FrameworkComputer/ExpansionBay/Dual SSD Reference Design/README.md

# Dual SSD Reference Design
This is a reference design of a Dual M.2 SSD Module that goes in the Expansion Bay Shell.  Note that other M.2 PCIe devices can also be used.

This design has been prototyped and put through limited testing, but additional validation is needed for a production version.

## License
Expansion Bay © 2023 by Framework Computer Inc is licensed under CC BY 4.0. To view a copy of this license, visit http://creativecommons.org/licenses/by/4.0/
