FrameworkComputer/ExpansionBay/PCB Reference Design/README.md

# PCB Reference Design
This is a reference drawing for a blank PCB that goes in the Expansion Bay Shell.  You can use it as a starting point for new PCBs.

## License
Expansion Bay © 2023 by Framework Computer Inc is licensed under CC BY 4.0. To view a copy of this license, visit http://creativecommons.org/licenses/by/4.0/
