FrameworkComputer/ExpansionBay/Mechanical/ExpansionBayShell/README.md

# Expansion Bay Shell
In order to place the PCBs at the right Z-height, you'll need to use standoffs.
A 3D-printable version is in this folder.  You can also request SMT versions through
the form here: https://forms.gle/iLWjxfMheLws1QaY7
