FrameworkComputer/ExpansionBay/Mechanical/ExpansionBayShell/fw_expansion_bay_standoff_1_long.stl

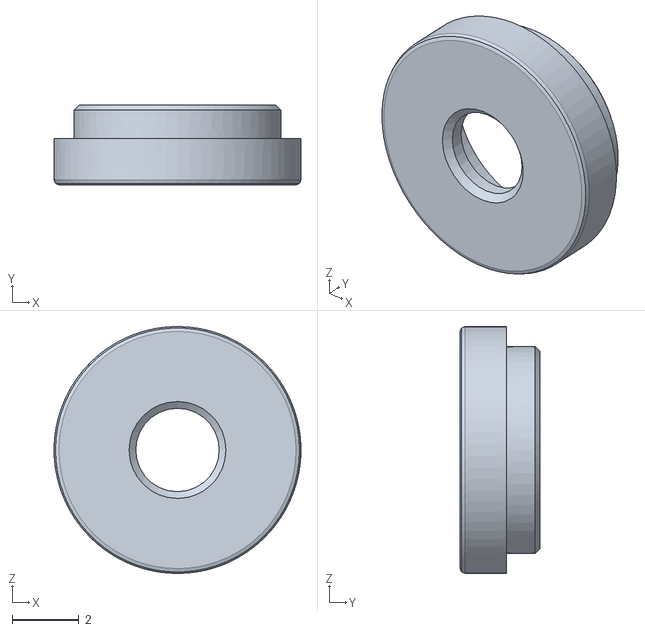
[picture p1: CAD file, 2025-09-09]
Mechanical/ExpansionBayShell/fw_expansion_bay_standoff_1_long.stl
7.40 x 2.40 x 7.40
