FrameworkComputer/ExpansionBay/PCB Reference Design/fw_expansion_bay_pcb_02_0807.dxf

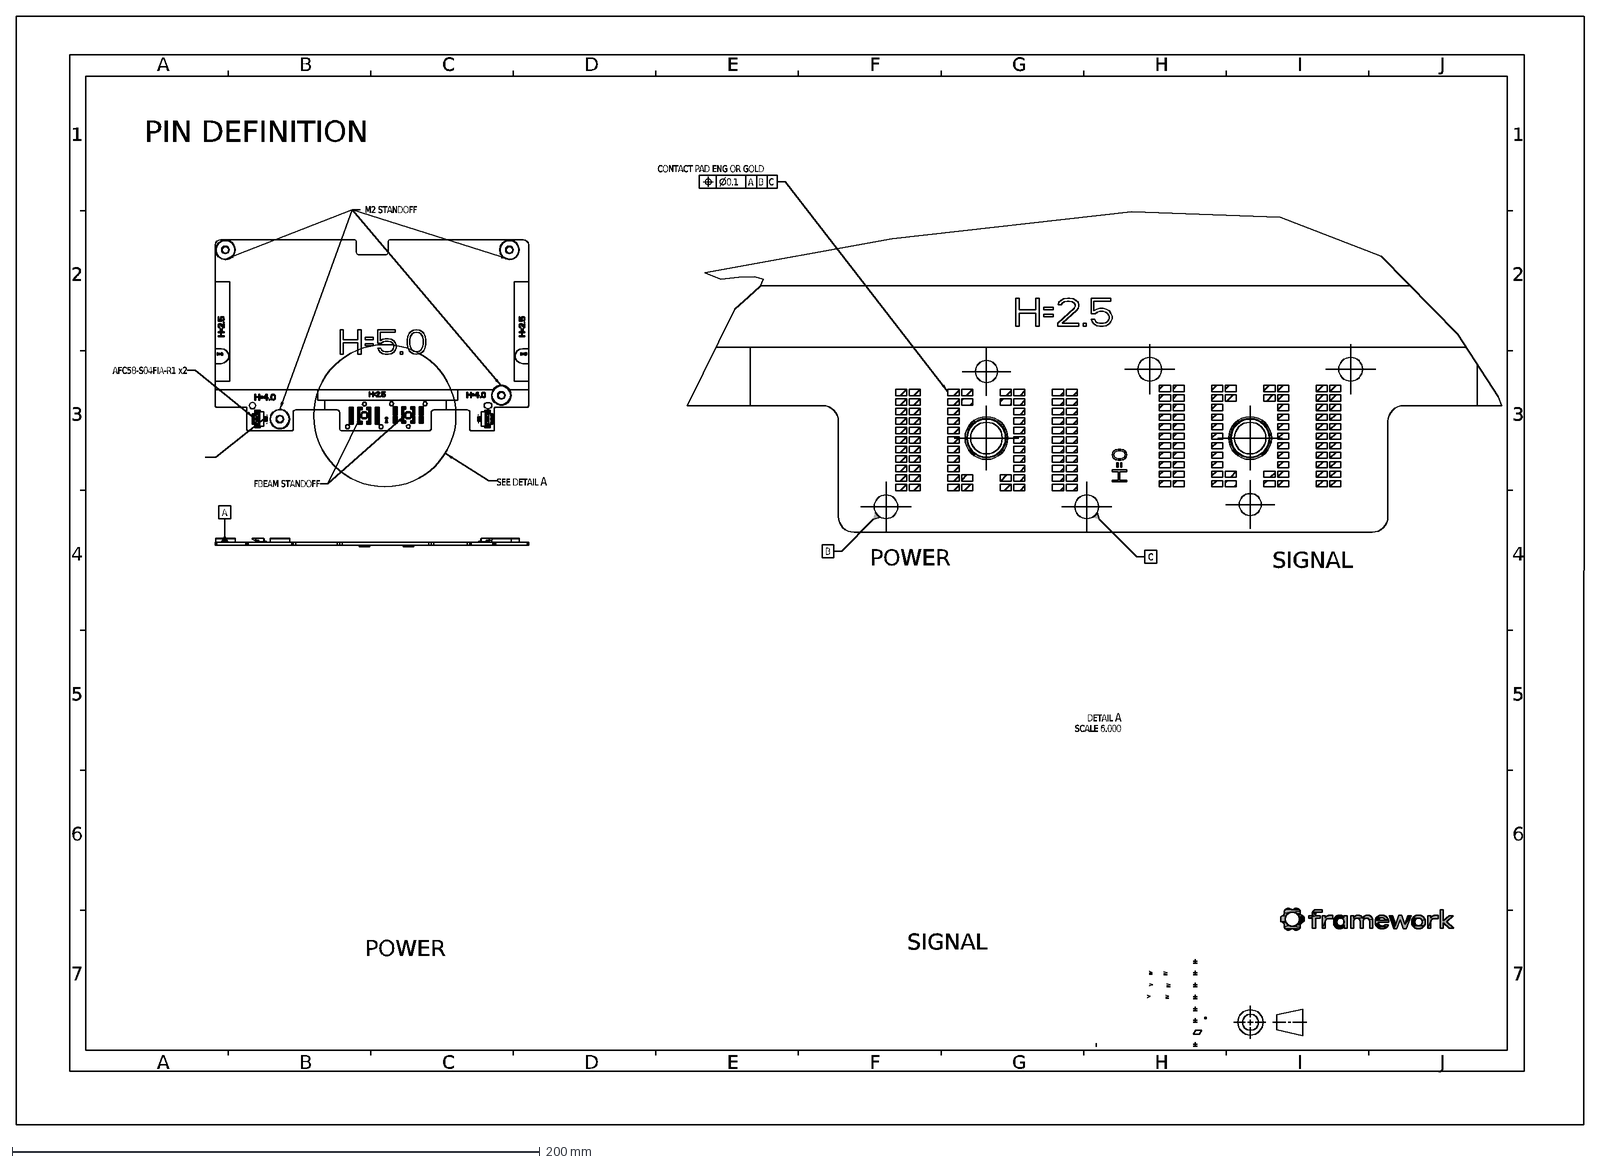
[picture p2: CAD file, 2023-08-07]
PCB Reference Design/fw_expansion_bay_pcb_02_0807.dxf
A
7
6
5
C
B
D
1
4
3
2
E
F
G
H
I
J
PIN DEFINITION
POWER
SIGNAL
SEE DETAIL A
AFC58-S04FIA-R1 x2
M2 STANDOFF
FBEAM STANDOFF
DETAIL A SCALE 6.000
CONTACT PAD ENG OR GOLD
0.1
