FrameworkComputer/ExpansionBay/Dual SSD Reference Design/fw_ssd_pcb_ref_design_0_1.dxf

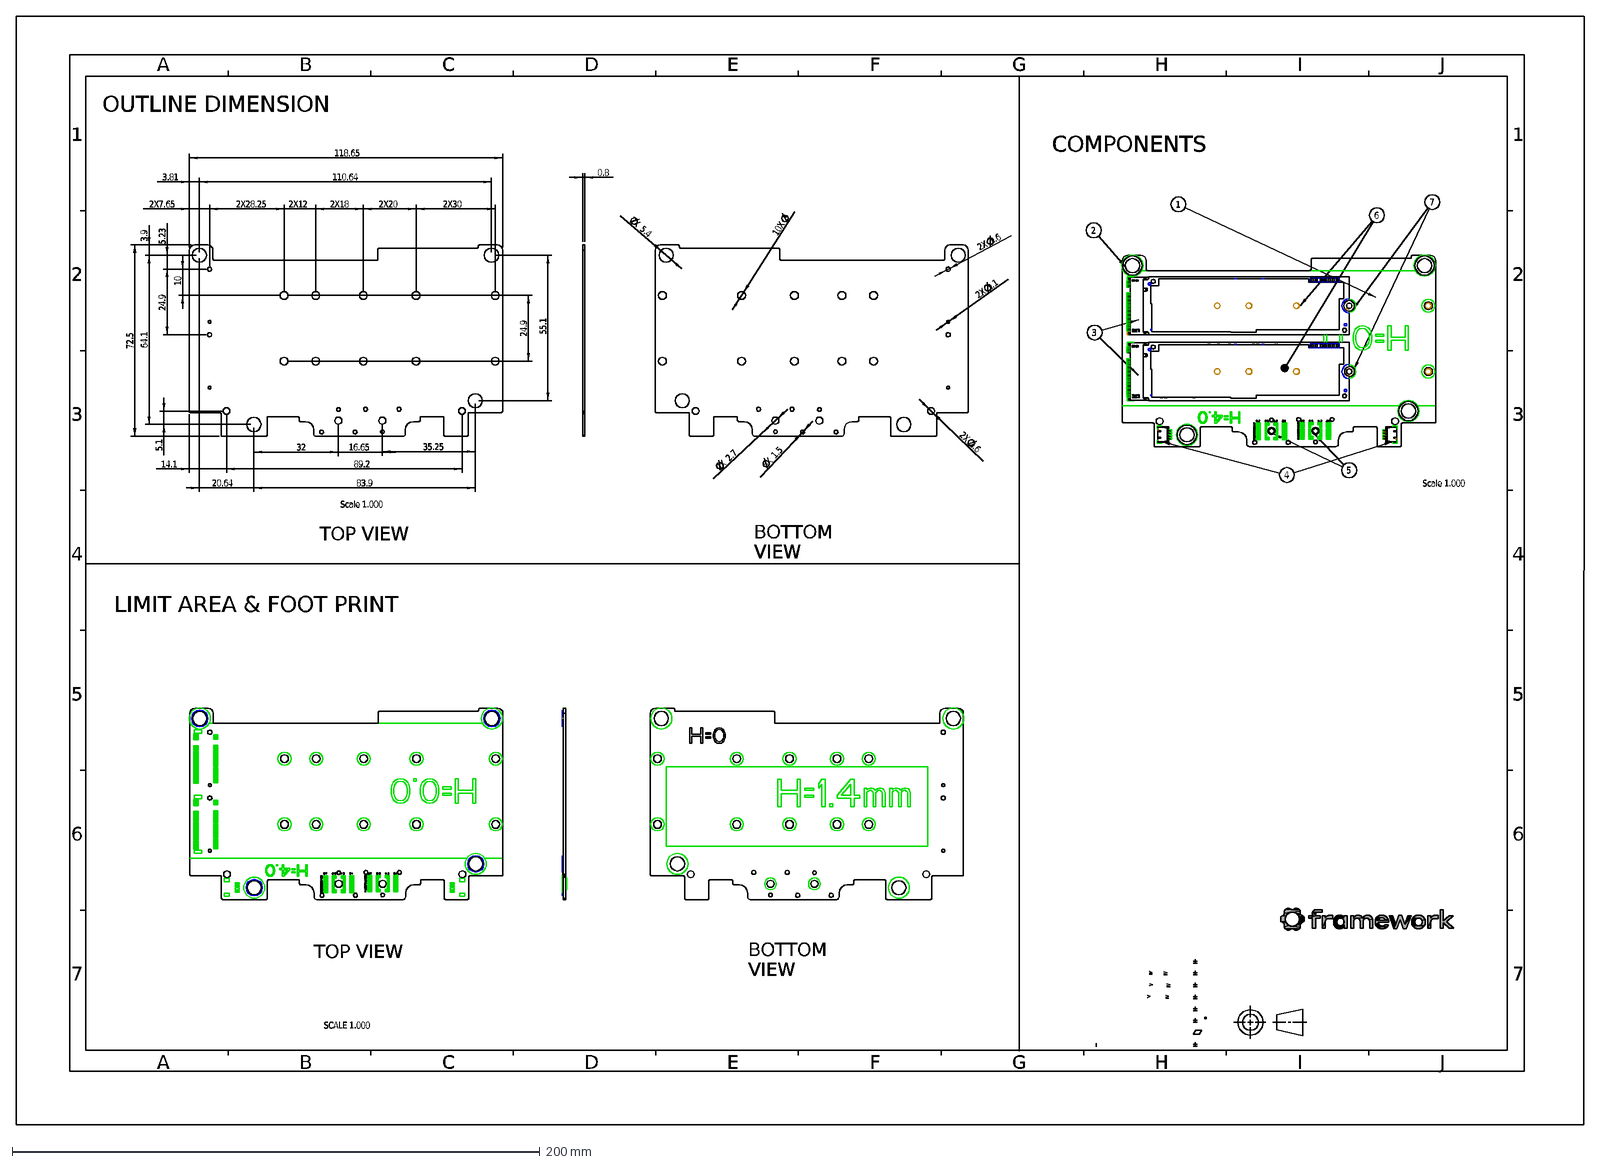
[picture p3: CAD file, 2023-03-20]
Dual SSD Reference Design/fw_ssd_pcb_ref_design_0_1.dxf
A
7
6
5
C
B
D
1
4
3
2
E
F
G
H
I
J
118.65
72.5
0.8
3.81
64.1
2X28.25
2X7.65
2X12
2X18
2X20
2X30
110.64
5.23
24.9
10
89.2
5.1
3.9
20.64
83.9
55.1
14.1
32
16.65
35.25
2X \~5.4
10X \~3
2X \~1.6
2X \~1.1
2X \~2.6
2X \~2.7
6X \~1.5
OUTLINE DIMENSION
TOP VIEW
BOTTOM VIEW
LIMIT AREA & FOOT PRINT
COMPONENTS
Scale 1.000
SCALE 1.000
