FrameworkComputer/ExpansionBay/PCB Reference Design/fw_expansion_bay_pcb_01_0807.dxf

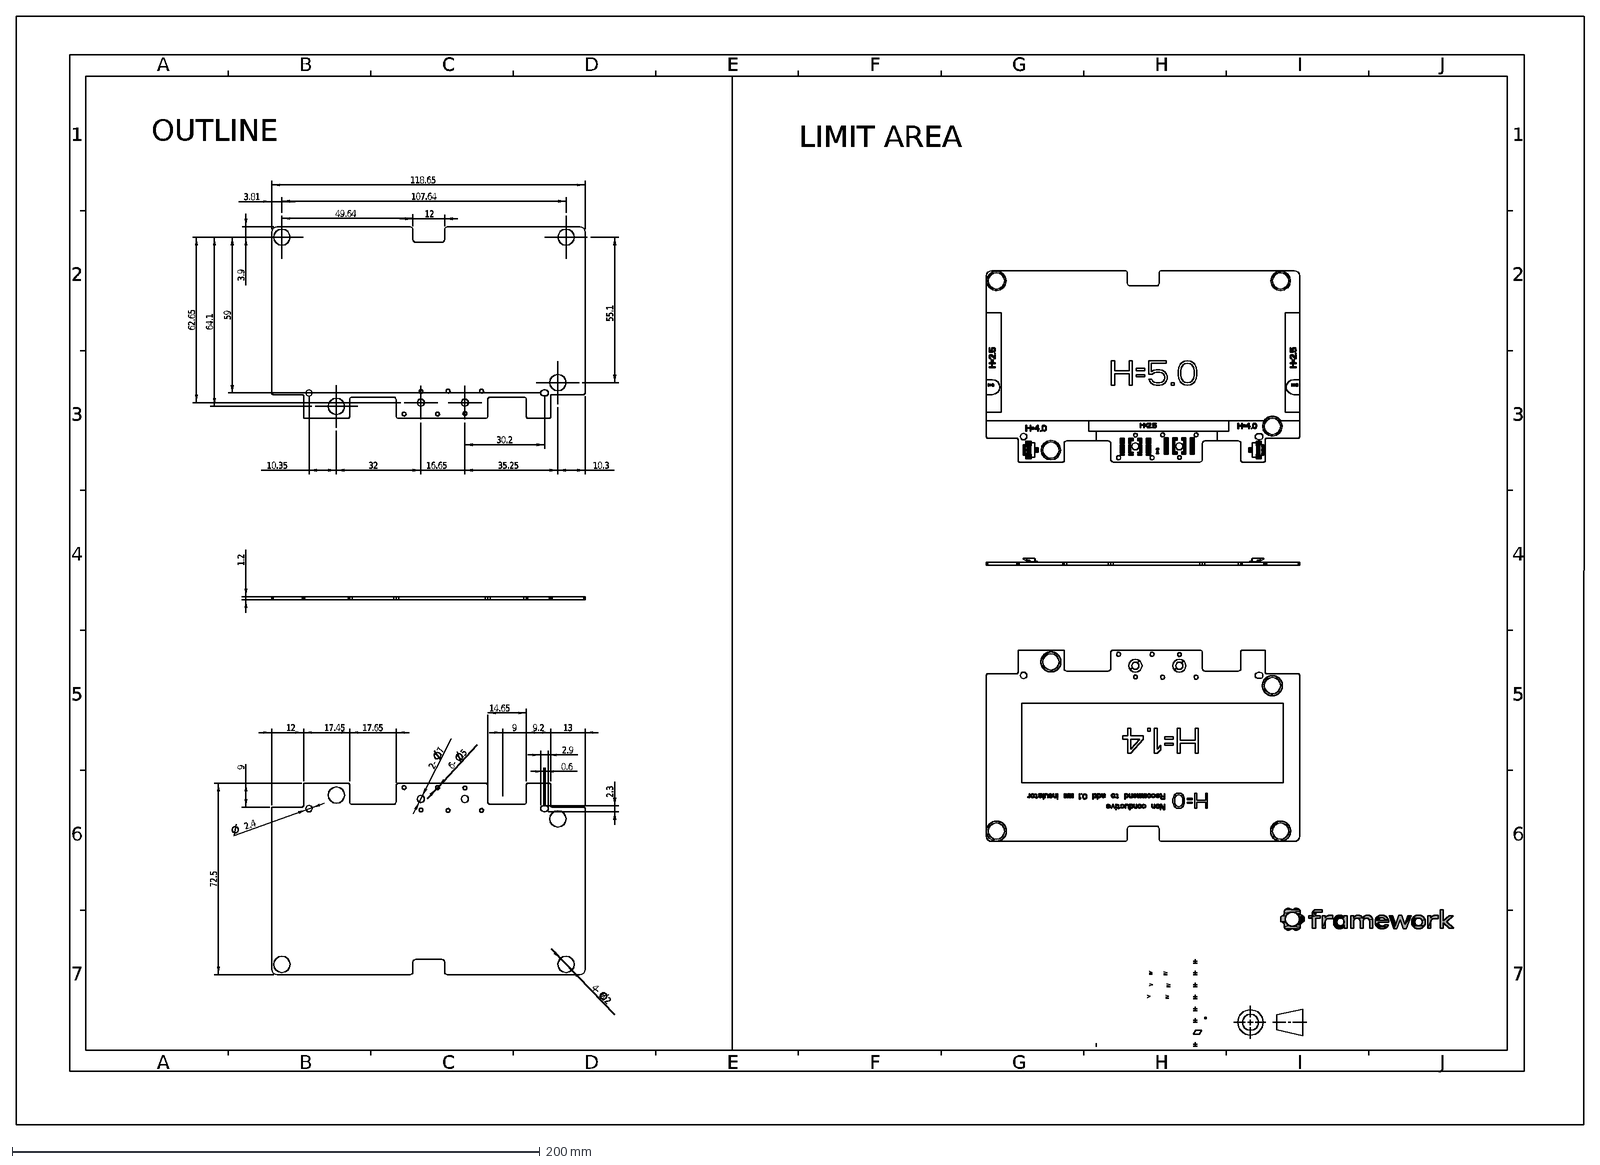
[picture p4: CAD file, 2023-08-07]
PCB Reference Design/fw_expansion_bay_pcb_01_0807.dxf
A
7
6
5
C
B
D
1
4
3
2
E
F
G
H
I
J
1.2
107.64
118.65
3.9
3.81
64.1
32
16.65
35.25
10.3
10.35
30.2
59
62.65
9
72.5
12
17.65
14.65
9.2
13
17.45
49.64
55.1
4- \~6.2
2- \~2.7
6- \~1.5
2.4
0.6
2.9
2.3
LIMIT AREA
OUTLINE
