FrameworkComputer/ExpansionBay/(list of files, cad)

Other CAD files:
Dual SSD Reference Design/fw_ssd_pcb_ref_design_0_2.dxf
