FrameworkComputer/ExpansionBay/(threads)

Thread 1 (2023-04-02):

How do I open the files in kicad 7.0?

Redstone626, 2023-04-02:
this is my first time using Kicad and I would like to try and make something for the 16in framework but don't know how to open these files in Kicad

eclecticc, 2023-04-15:
These are mechanical drawings.  I recommend waiting until we or a community member create a KiCAD template using them.

Closed 2023-04-15.

Thread 2 (2023-04-02):

Estimated thickness, External ports?

maxtim10, 2023-04-02:
Need the dimensions and details of not just PCBA but the housing.  Planning to start development work on an industry-specific expansion module, but I need to at least know the rough dimensions to determine feasibility.

In the Framework announcement, it was stated thickness can be whatever, but I'm sure the PCBA will need a connection port to "slot in" the mainboard.

Another point that I need clarification on is will the housing be all the way at the back of the laptop for potentially additional port additional ports, etc.

NickelLiang, 2023-04-03:
Also want to have more details about the dimensions of the housing, also planning on an industry-specific expansion module.

We already know that our expansion module definitely will not fit in the standard Expansion Bay Shell, so a reference design for Graphics Module / no Z-height limitation module will be of great help for us to evaluate the feasibility of implementing our solution as a module for Framework 16.

Thanks!

Cutieguwu, 2024-01-23:
Going to quickly bump this.

Details regarding the housing design and base construction are very important for custom module design. Expanding the housing from a base model is easy if you don't have to reconstruct all of the housing in contact with the laptop beforehand (Connectors, rails, etc). Also helpful if you plan to produce a module for a shell before you have the laptop on hand. Then you can at least begin the initial design and build stage before proper testing.

Thread 4 (2023-05-19):

Where does the DisplayPort connector lead?

Dakkaron, 2023-05-19:
Does it go to the internal display (thus bypassing the need to route the video signal over PCIE), to the IO (to attach external displays) or somehow to the CPU/integrated GPU?

Or is it the output coming from the iGPU?

What can it be used for?

Dakkaron, 2023-06-14:
That's really cool, thanks!

jyancat, 2023-06-21:
I'd suggest you mark this as closed.

Closed 2023-06-21.

Thread 7 (2023-08-03):

Exact PCB dimensions & Case Interface port

Seneral, 2023-08-03:
I'd like to verify the dimensions and shape of the PCB.

First, the given PCB has cutouts when it is not obvious why they are there - e.g. the large retreating edge where the interface slot in the shell casing should be, as well as the cutouts next to the bottom edge hole cutouts (where the GPU shell does allow for PCB according to earlier videos and photos).
Can you confirm the shell allows for the following additional PCB space to be used?
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

Especially the top edge is important. In addition to what the shell back end will look like in regards to distance to the specified PCB edge. From videos I already inferred the removable backend for ports likely spans the entire 118.65mm - is that also correct?

Thank you for the help

Seneral, 2023-08-03:
I overlayed them in an image editor and there seem to be a few minor changes.
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
As expected, the interface connector changed (the verge mentioned they used a temporary one for the shell), the left fan header moved a bit, and the PCB shape changed a bit.

But the top confuses me. None of the three holes are screwed in, which means they are likely not responsible for the port cover mounting. But the given PCB shape also covers the middle screw, so probably nothing above uses it. Is it solely for the PCB to use, in case it goes beyond the shell bounds?
This would be beneficial since we could then ignore the side screws and use a 100mm wide board, which is a LOT cheaper at e.g. jlcpcb.

Additionally, it seems there is still quite a bit of space between the PCB edge and the port cover, so we'd definitely need details or we'd have completely recessed ports

Again thanks for any additional information

Closed 2024-04-28.

Thread 8 (2023-08-05):

Purpose of PCIe Clock Buffer in Dual SSD Reference Design

Seneral, 2023-08-05:
Hello,
Looking at the SSD Reference Design, you employ the PI6CB33202 PCIe Clock Buffer.
By default it is in PLL Bypass mode (so both outputs are always on, with the input clock being passed through), however it could in theory be used to disable or re-drive the clock signal for each port using the SMBus/I2C interface.
Is this actively used in modern OSs by default? I have not found any information on default I2C drivers for adress 0x6C, which indicates the clock buffer is by default only a vehicle for the clock termination resistors.

Additionally, the pinout specifies that if the board uses two ports, it should use two separate CLKREQ and REFCLK for them (sacrificing DP AUX lanes), which the reference design does not. This should in theory eliminate the need for the clock buffer entirely, correct?

Can I assume the clock buffer is a remnant from a time when the Expansion Bay Interface did not yet include the alternate pinouts for two separate PCIe ports?
And/or do future Frameworks contain firmware that expect to be able to turn disable each individual port using the PI6CB33202 PCIe Clock Buffer with I2C adress 0x6C?

Thanks for any information. For now I will assume the alternate pinouts are valid and sufficient

PS: I believe the PEX_REFCLK signal being marked as output is wrong, it should be input (to the expansion board)

PS 2: I noticed both SSDs use the same CLK_REQ signal, indicating that one SSD requesting a low-power state would disable both SSDs REF_CLK. This makes me assume the alternate pin assignment was introduced later and is the only solution to use, meaning the current Dual SSD reference design is out of date. Correct?

Seneral, 2023-08-05:
On that note, the SSD reference design doesn't even use EXT_SSD2_CLK_REQ and the other SSD-specific pins. So I assume it is truly outdated.

Another question that is wide open is how is the second PCIe port activated then, so that DP AUX is disabled?
Is it controlled over the yet undocumented DDS I2C (Expansion Bay Module control)?

Side note, this is not relevant to me specifically anymore, since it sacrifices the DP AUX pair which seems to be required for DP to work, I opted to use the original REFCLK (and pull CLKREQ down)

Closed 2023-10-19.

Thread 9 (2023-08-06):

AC Coupling Capacitor on Differential Pairs

Seneral, 2023-08-06:
Can we assume both DisplayPort and PCIe TX lanes have AC coupling capacitors on the motherboard, or does the design assume we use the 3V/5V given as a power supply for the receiver?
From [quick research](https://electronics.stackexchange.com/a/364996) they could have been omitted if that assumption was made.
The reason I am asking is because I plan to route the PCIe lanes outside the chassis using OCuLink, so the receiver will obviously use a different power supply. Having to place them myself this far after the transmitter would add a lot of reflections to my knowledge.

Closed 2023-10-19.
