FrameworkComputer/ExpansionBay/Dual SSD Reference Design/ssd holder_r00_20230105pm.pdf

# MODEL : SSD HOLDER

# Revision : R00

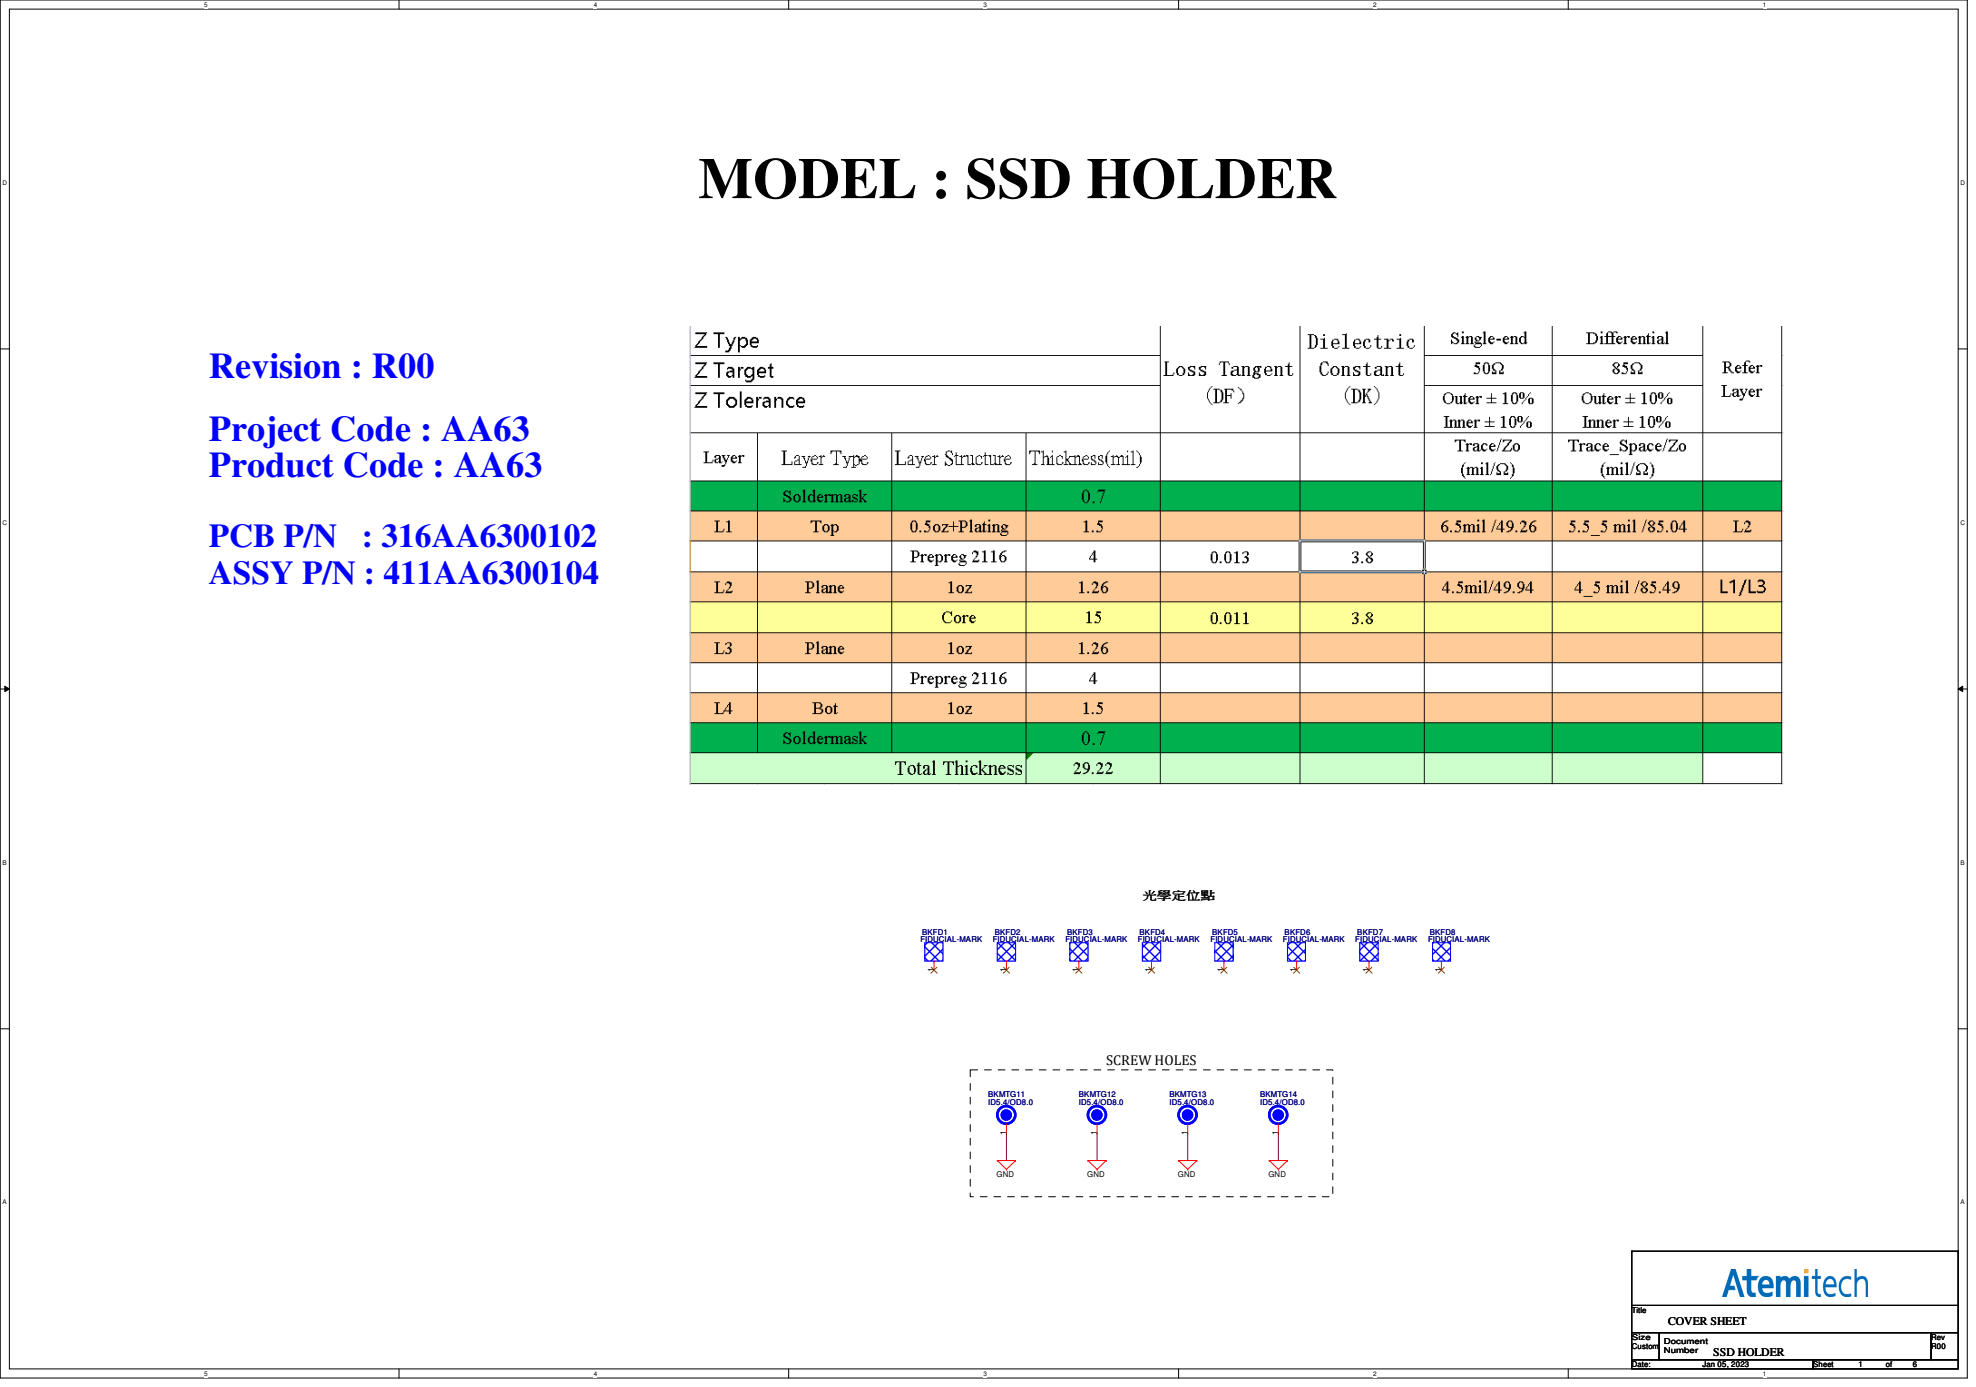
[picture p9: page 1]
GND; Title; Size; Document; Number; Rev; Date:; Sheet; SSD HOLDER; COVER SHEET; Custom; Jan 05, 2023; 光光光光光; SCREW HOLES; ASSY P/N : 411AA6300104; Project Code : AA63; PCB P/N : 316AA6300102; Product Code : AA63; BKMTG13 ID5.4/OD8.0; BKFD7 FIDUCIAL-MARK; BKFD1 FIDUCIAL-MARK; BKMTG12 ID5.4/OD8.0; BKFD6 FIDUCIAL-MARK; BKMTG11 ID5.4/OD8.0; BKFD5 FIDUCIAL-MARK; BKFD4 FIDUCIAL-MARK; BKFD3 FIDUCIAL-MARK; BKFD8 FIDUCIAL-MARK; BKFD2 FIDUCIAL-MARK; BKMTG14 ID5.4/OD8.0

# M.2 SSD (M-KEY)

# 130mil

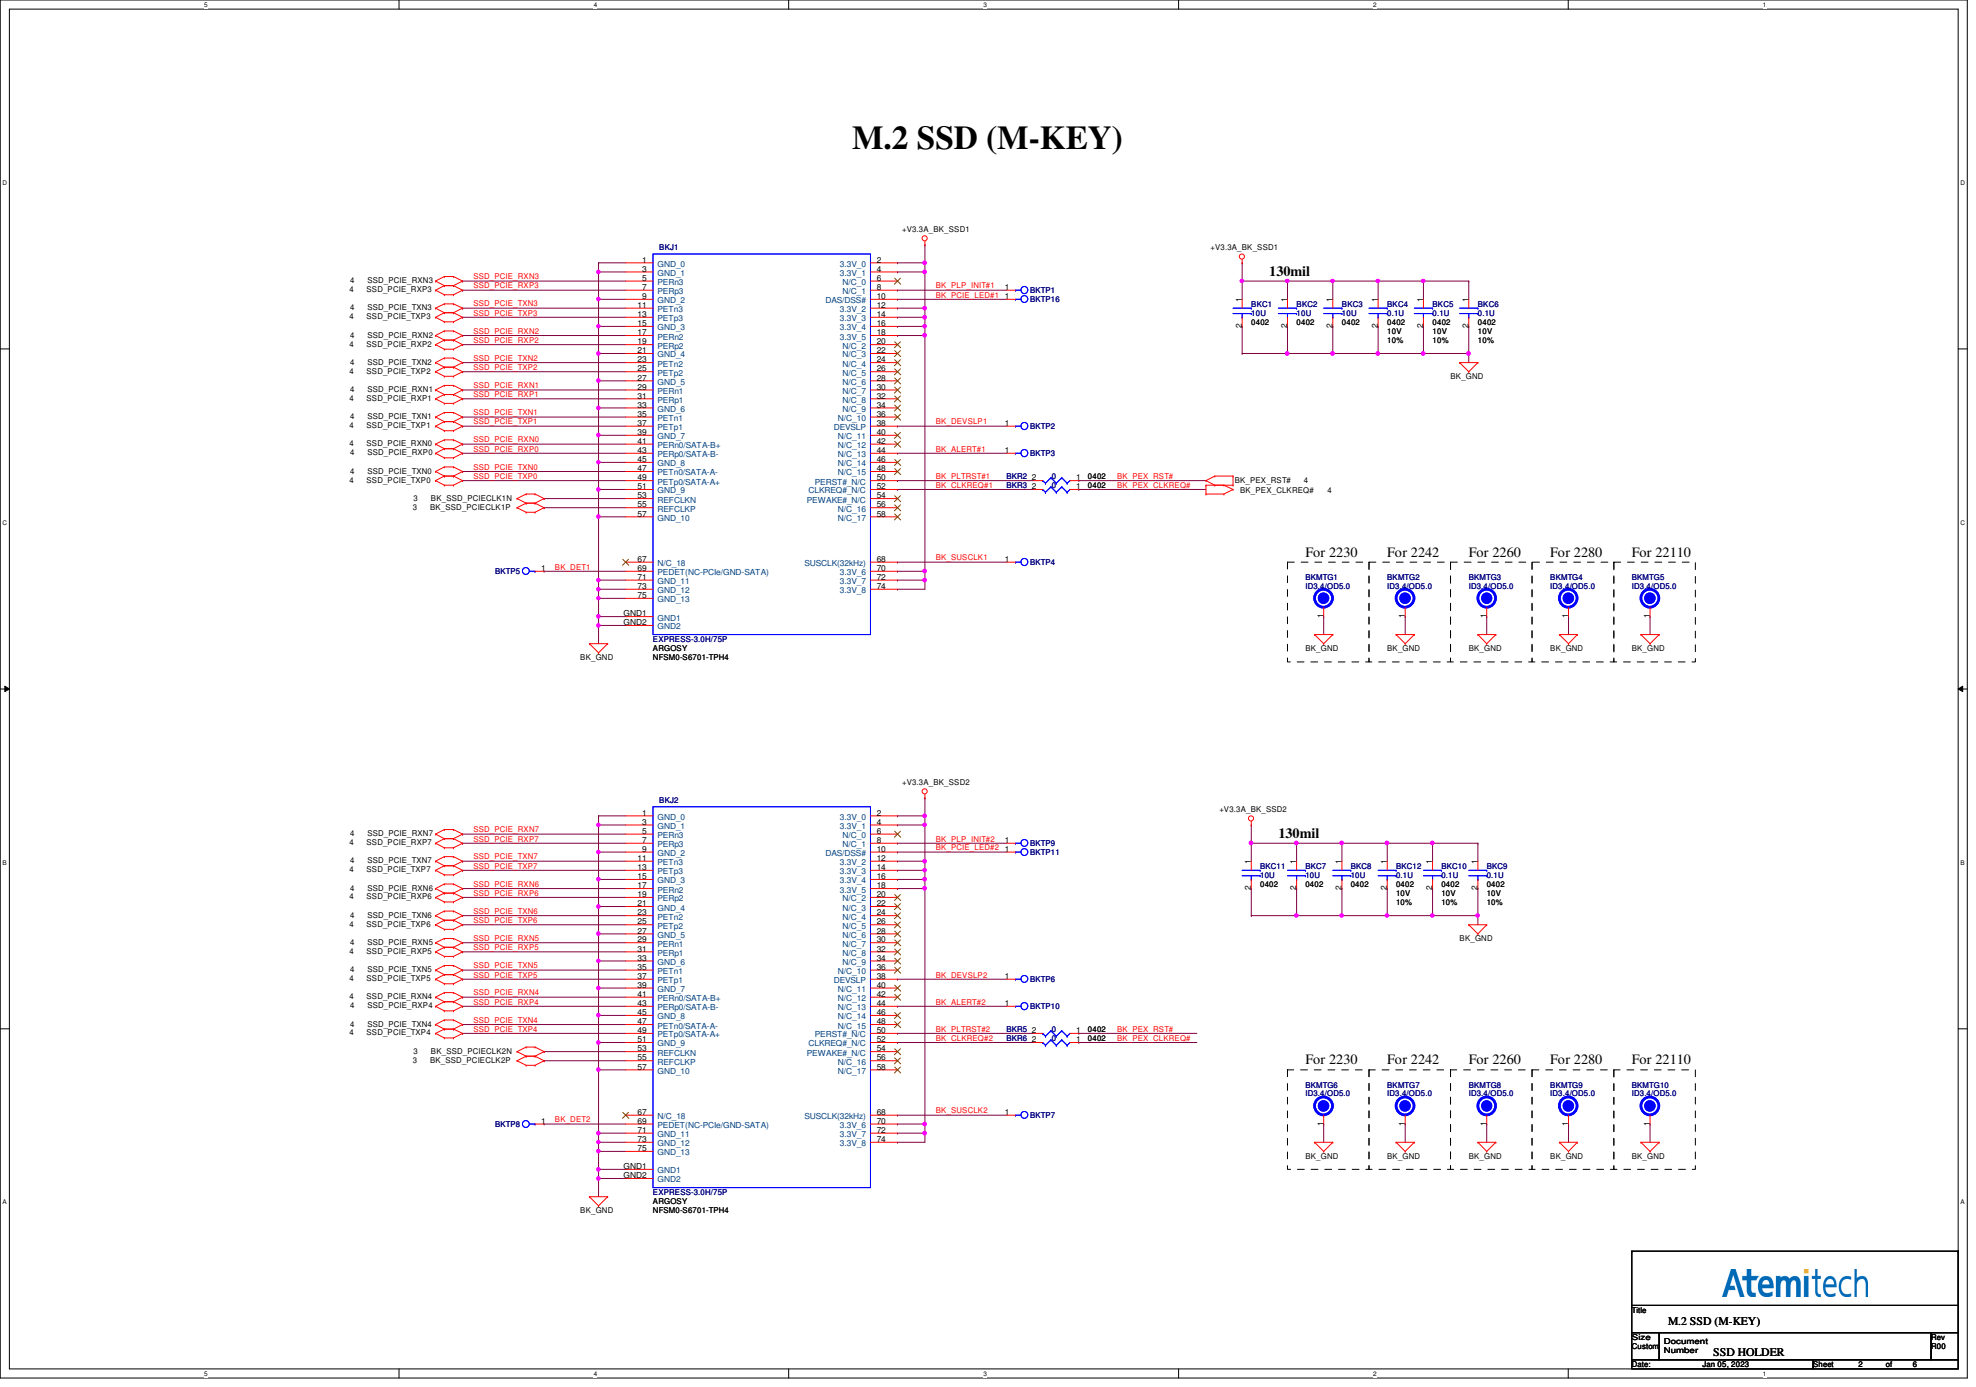
[picture p10: page 2]
BK_PLTRST#1 BK_CLKREQ#1; SSD_PCIE_TXP3; SSD_PCIE_TXN3; SSD_PCIE_RXN3 SSD_PCIE_RXP3; SSD_PCIE_RXP2; SSD_PCIE_RXN2; SSD_PCIE_RXN1 SSD_PCIE_RXP1; SSD_PCIE_TXN1 SSD_PCIE_TXP1; BK_SUSCLK1; BK_DEVSLP1; BK_PCIE_LED#1; BK_DET1; SSD_PCIE_TXN2 SSD_PCIE_TXP2; SSD_PCIE_TXN0 SSD_PCIE_TXP0; SSD_PCIE_RXN0 SSD_PCIE_RXP0; BK_PLP_INIT#1; BK_ALERT#1; BK_PEX_RST# BK_PEX_CLKREQ#; SSD_PCIE_RXN4 SSD_PCIE_RXP4; BK_PLP_INIT#2; BK_ALERT#2; BK_PLTRST#2 BK_CLKREQ#2; SSD_PCIE_TXP7; SSD_PCIE_TXN7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

# PCIE CLOCK BUFFER (PI6CB33202ZDIEX)

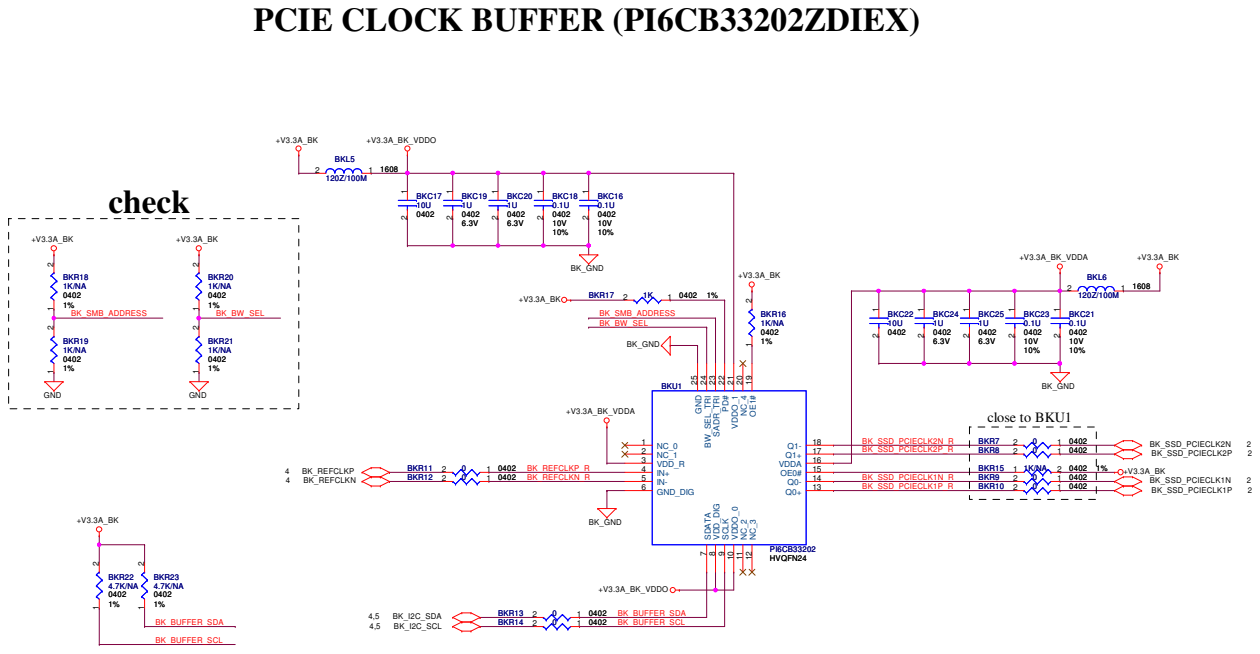
[picture p11: page 3]
BK_SSD_PCIECLK2N_R BK_SSD_PCIECLK2P_R; BK_SSD_PCIECLK1N_R BK_SSD_PCIECLK1P_R; BK_REFCLKP_R BK_REFCLKN_R; BK_BUFFER_SDA BK_BUFFER_SCL; BK_SMB_ADDRESS BK_BW_SEL; BK_SMB_ADDRESS; BK_BW_SEL; BK_BUFFER_SCL; BK_BUFFER_SDA; BK_SSD_PCIECLK2N; BK_SSD_PCIECLK2P; BK_SSD_PCIECLK1N; BK_SSD_PCIECLK1P; 4 BK_REFCLKP 4 BK_REFCLKN; BK_I2C_SDA; BK_I2C_SCL; BK_GND; +V3.3A_BK_VDDO; +V3.3A_BK_VDDA; GND; Jan 05, 2023; close to BKU1; check; BKR11; BKC21 0.1U 0402 10V 10%; BKC25 1U 0402 6.3V; BKR14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

PCIE CLOCK BUFFER (PI6CB33202ZDIEX)

# DUAL CHANNEL 74P PCB

# Signal PIN

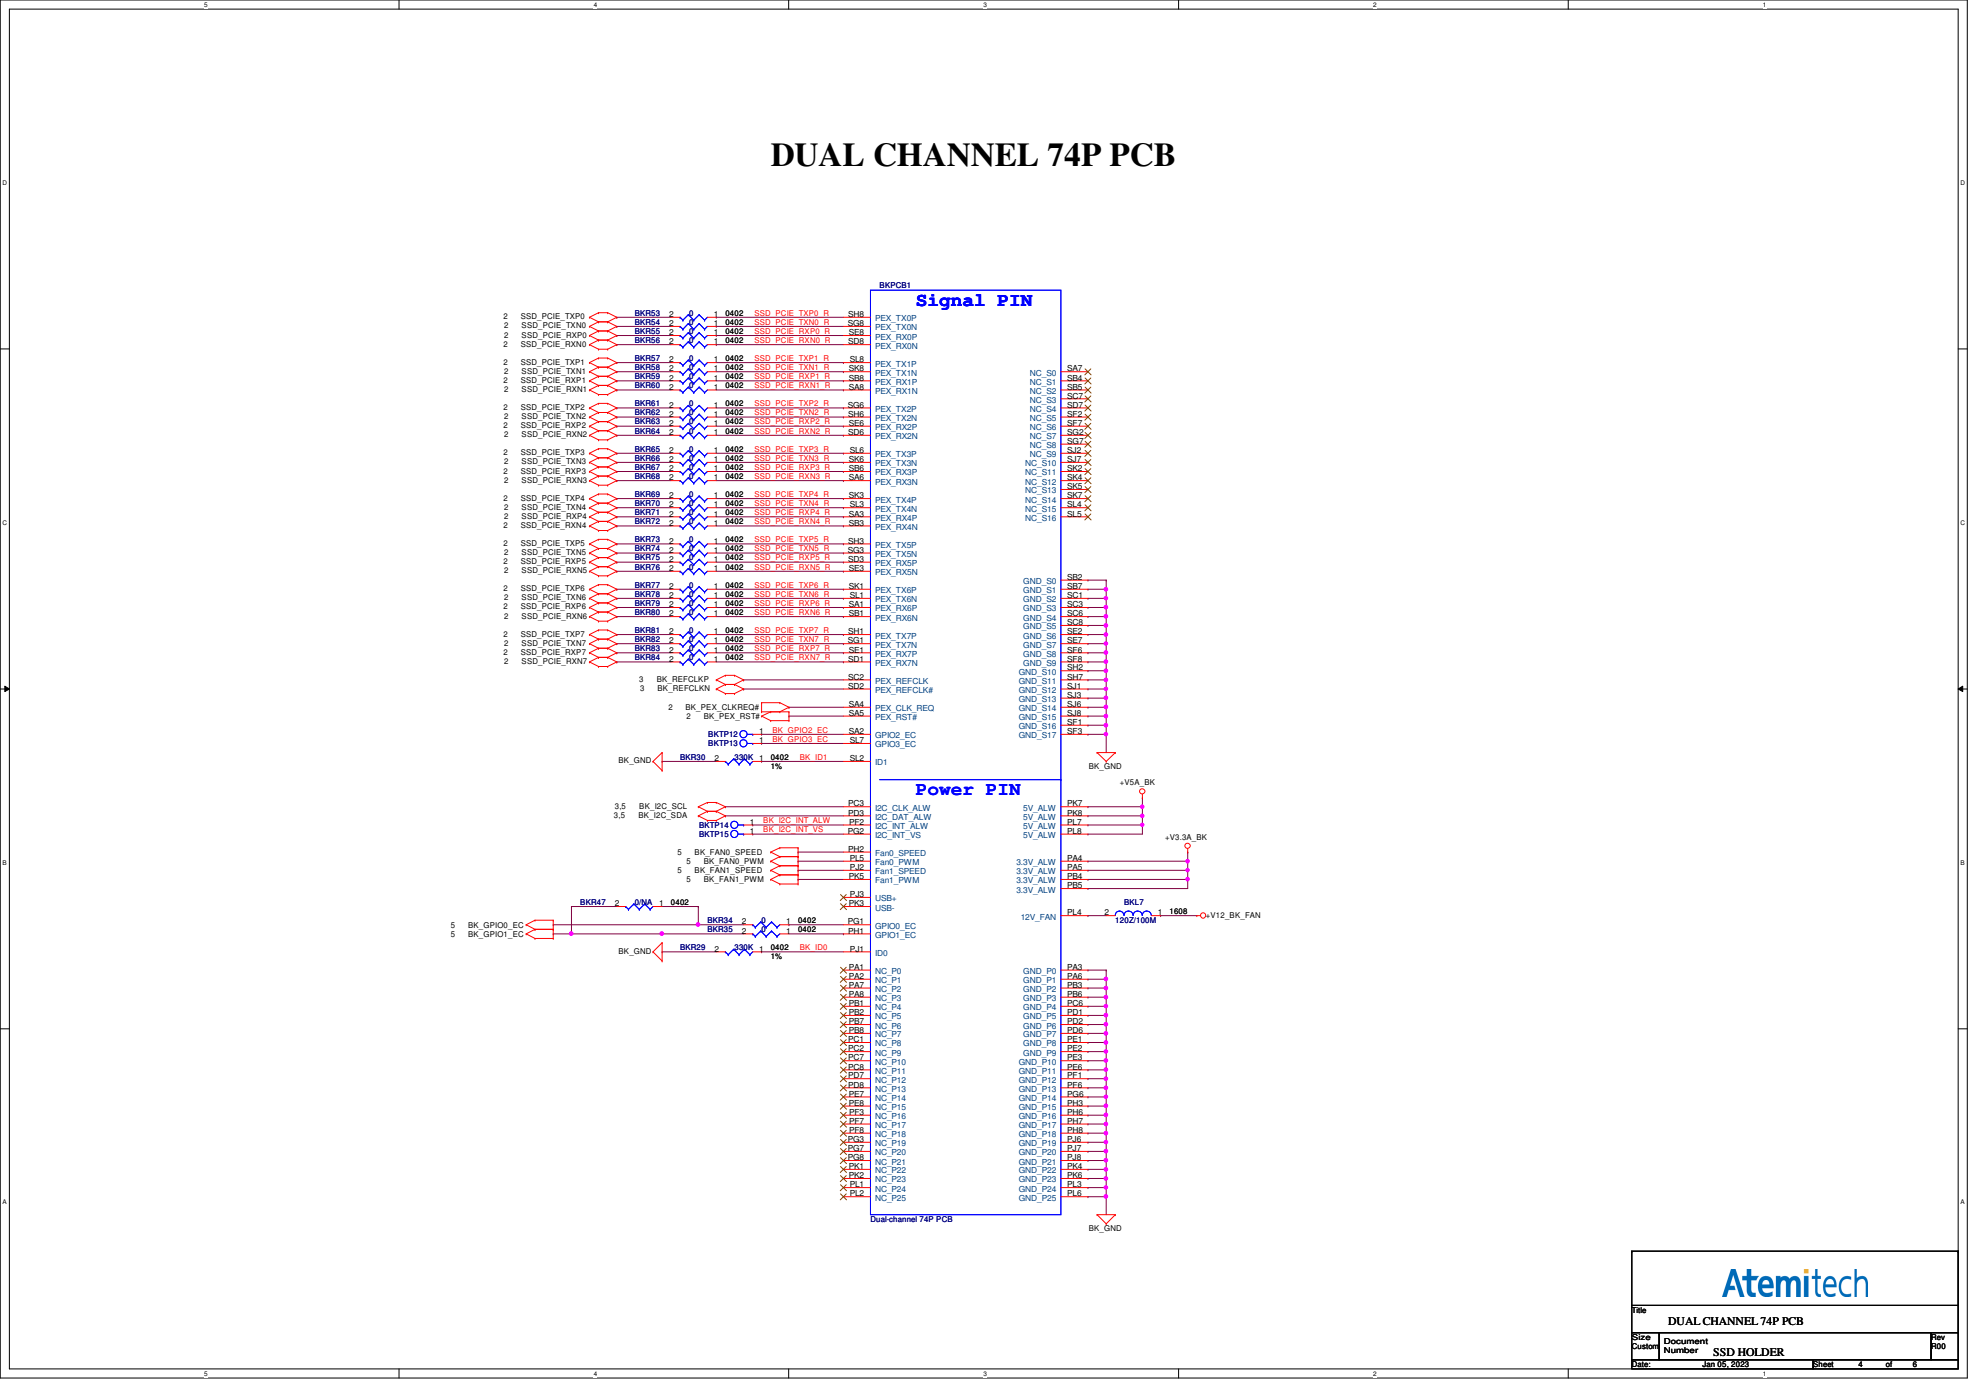
[picture p12: page 4]
BK_GPIO2_EC BK_GPIO3_EC; BK_I2C_INT_ALW BK_I2C_INT_VS; SSD_PCIE_TXP0_R SSD_PCIE_TXN0_R SSD_PCIE_RXP0_R SSD_PCIE_RXN0_R; SSD_PCIE_TXP1_R SSD_PCIE_TXN1_R SSD_PCIE_RXP1_R SSD_PCIE_RXN1_R; SSD_PCIE_TXP2_R SSD_PCIE_TXN2_R SSD_PCIE_RXP2_R SSD_PCIE_RXN2_R; SSD_PCIE_TXP3_R SSD_PCIE_TXN3_R SSD_PCIE_RXP3_R SSD_PCIE_RXN3_R; SSD_PCIE_TXP4_R SSD_PCIE_TXN4_R SSD_PCIE_RXP4_R SSD_PCIE_RXN4_R; SSD_PCIE_TXP5_R SSD_PCIE_TXN5_R SSD_PCIE_RXP5_R SSD_PCIE_RXN5_R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

Dual-channel 74P PCB

DUAL CHANNEL 74P PCB

# EEPROM & FAN & POWER GATE

# FAN CONN

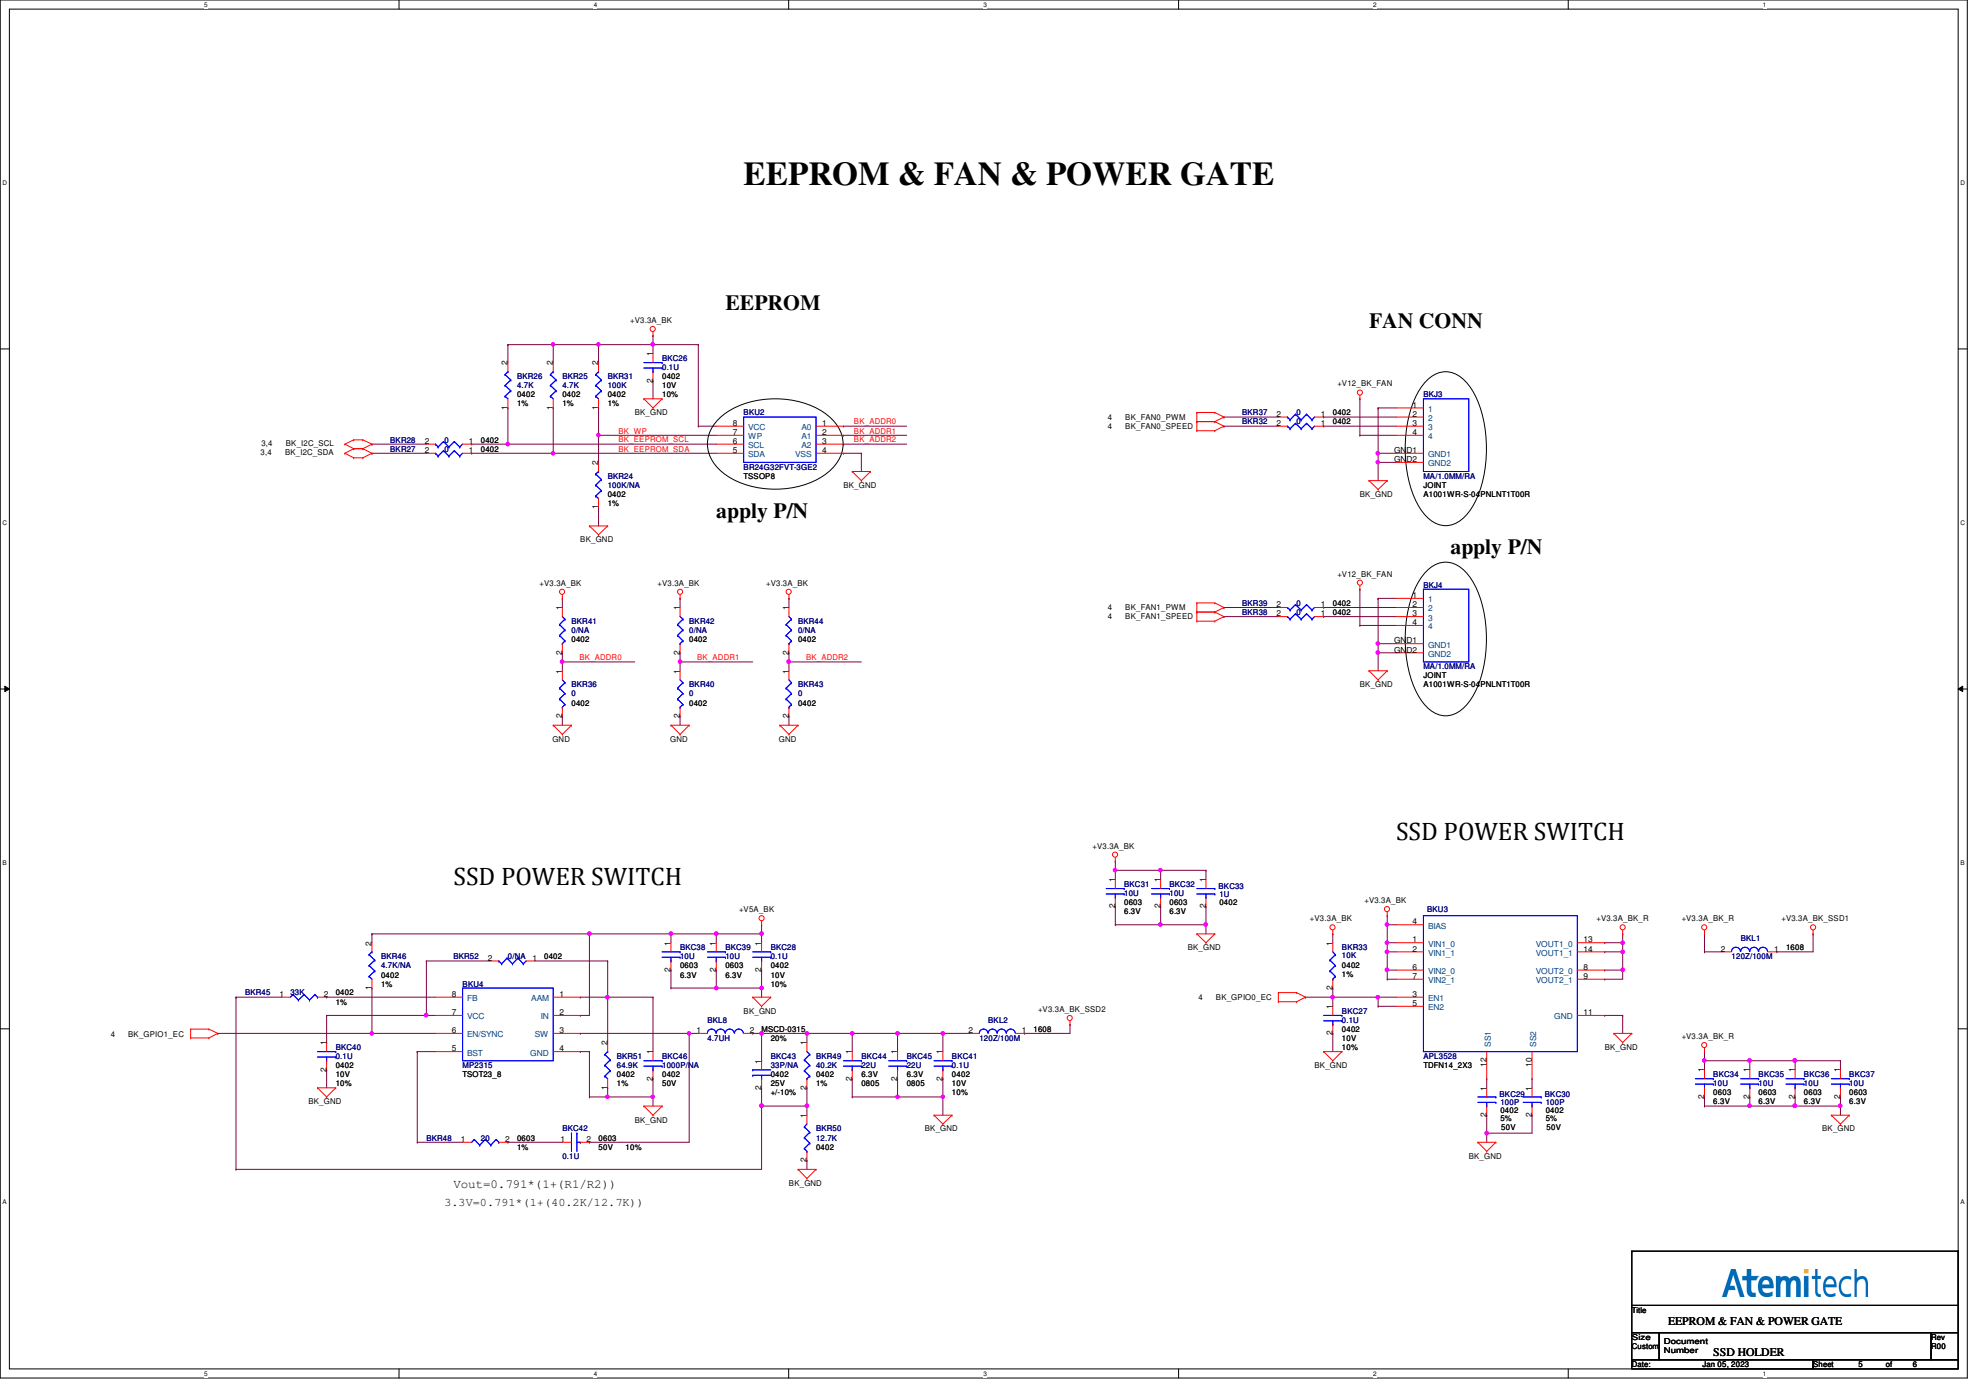
[picture p13: page 5]
BK_ADDR0 BK_ADDR1 BK_ADDR2; BK_EEPROM_SDA; BK_EEPROM_SCL; BK_ADDR0; BK_ADDR1; BK_ADDR2; BK_I2C_SDA; BK_I2C_SCL; 4 BK_GPIO0_EC; 4 BK_FAN0_PWM 4 BK_FAN0_SPEED; 4 BK_FAN1_PWM 4 BK_FAN1_SPEED; 4 BK_GPIO1_EC; +V12_BK_FAN; BK_GND; +V3.3A_BK_SSD1; GND; +V3.3A_BK_SSD2; Jan 05, 2023; apply P/N; EEPROM; Vout=0.791*(1+(R1/R2)); BKR52; BKL1; BKC29 100P 0402; BKC27 0.1U 0402 10V 10%; BKR27; BKL2; BKR50 12.7K 0402; BKC30 100P 0402; BKR32; BKU4; MP2315 TSOT23_8; AAM; VCC 7; BST 5; EN/SYNC 6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

SSD POWER SWITCH

EEPROM & FAN & POWER GATE

Issued Date | Remark

# HISTORY

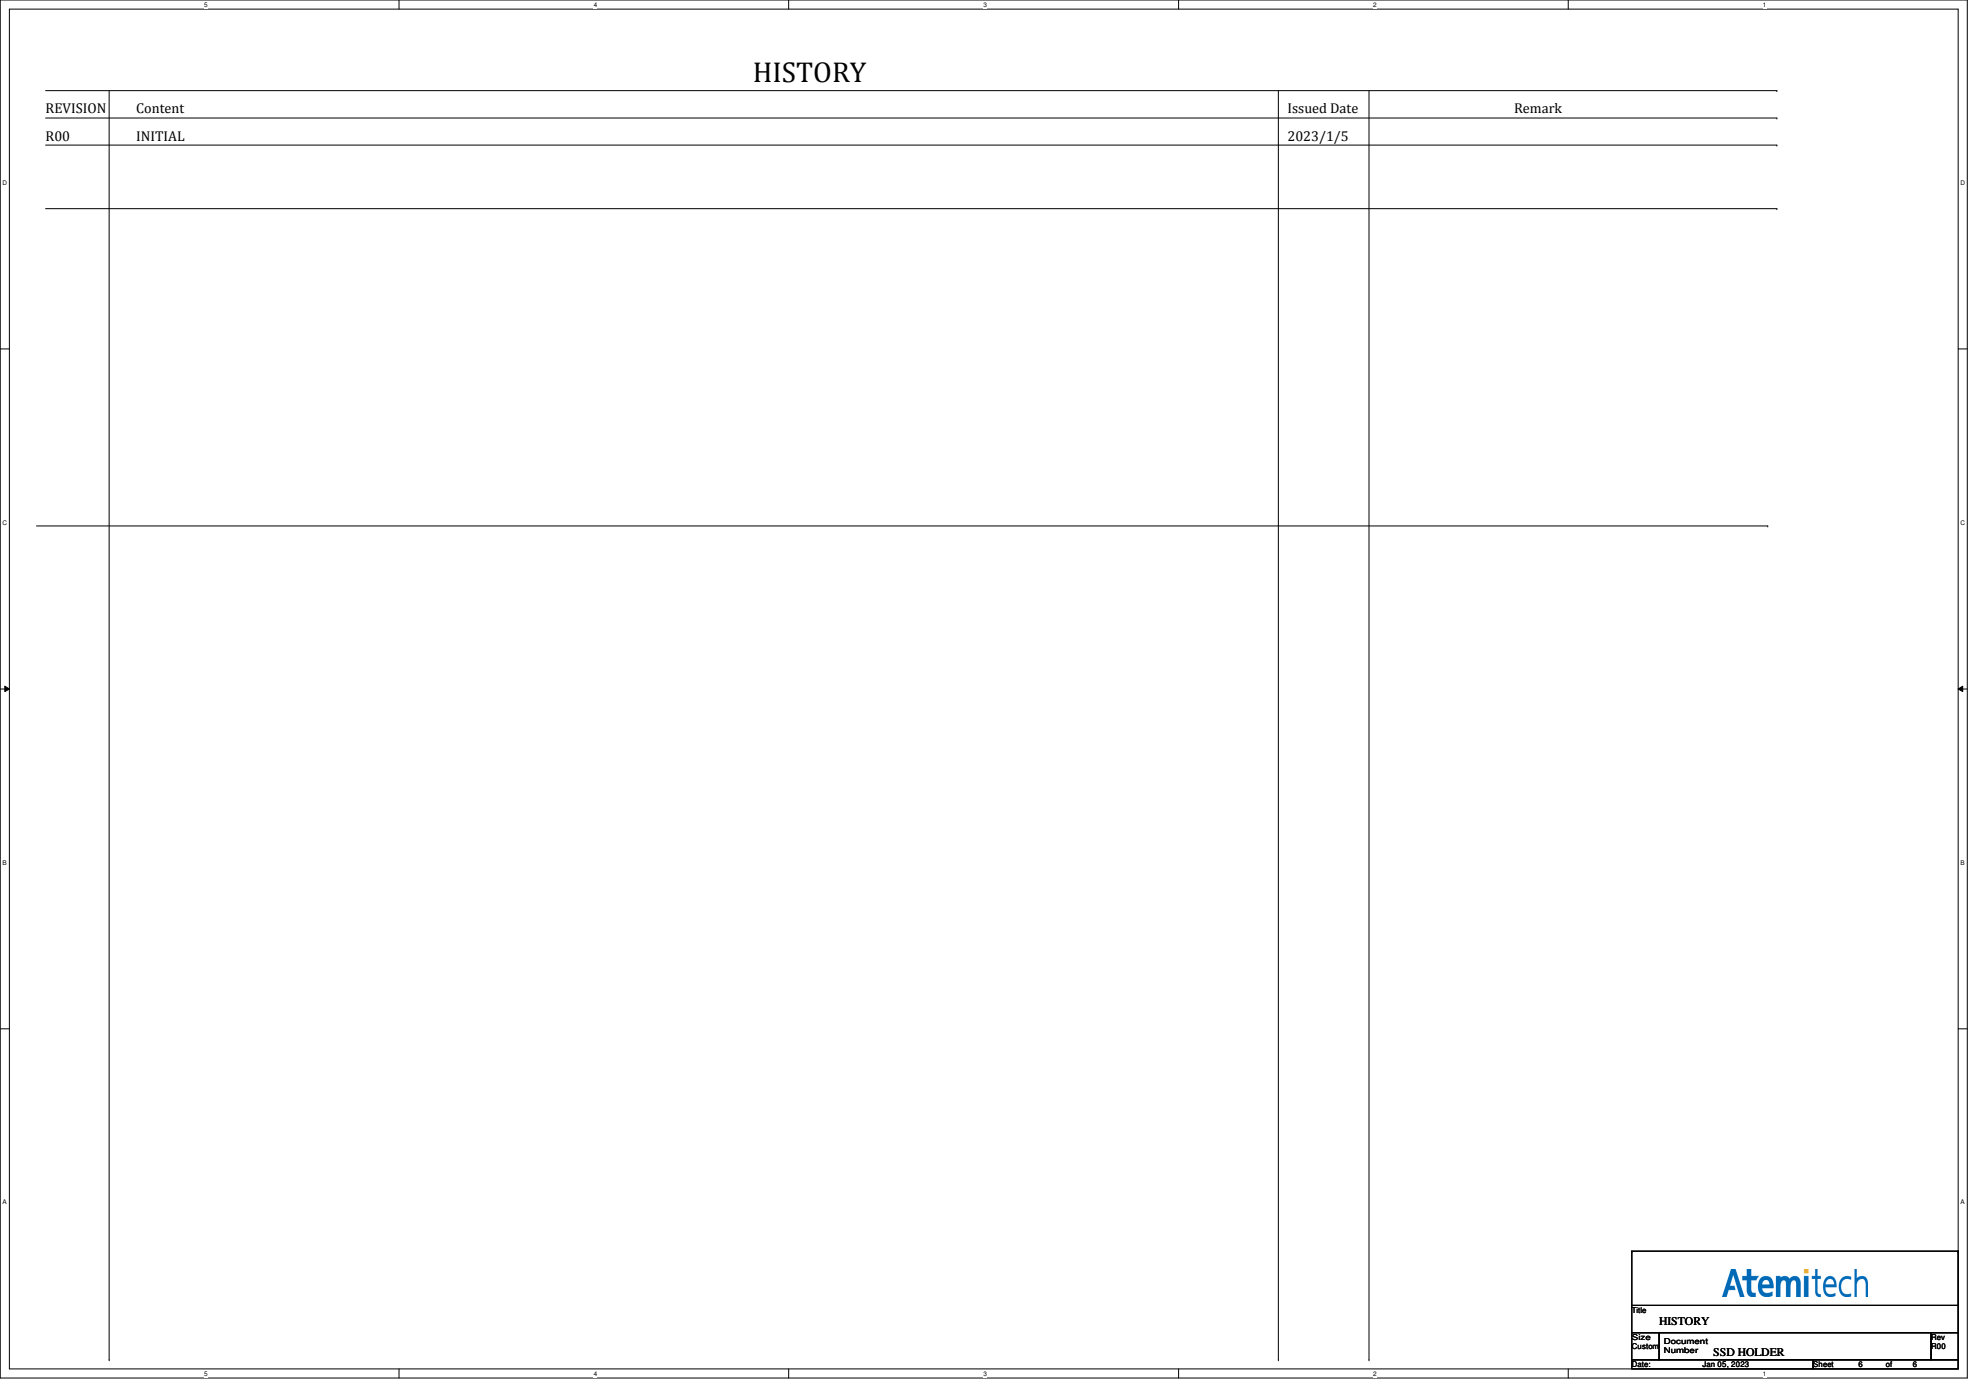
[picture p14: page 6]
HISTORY; Jan 05, 2023; Content; REVISION; INITIAL
