FrameworkComputer/ExpansionBay/Mechanical/ExpansionBayShell/FW_UMA_MODULE_REF_0.pdf

2

1

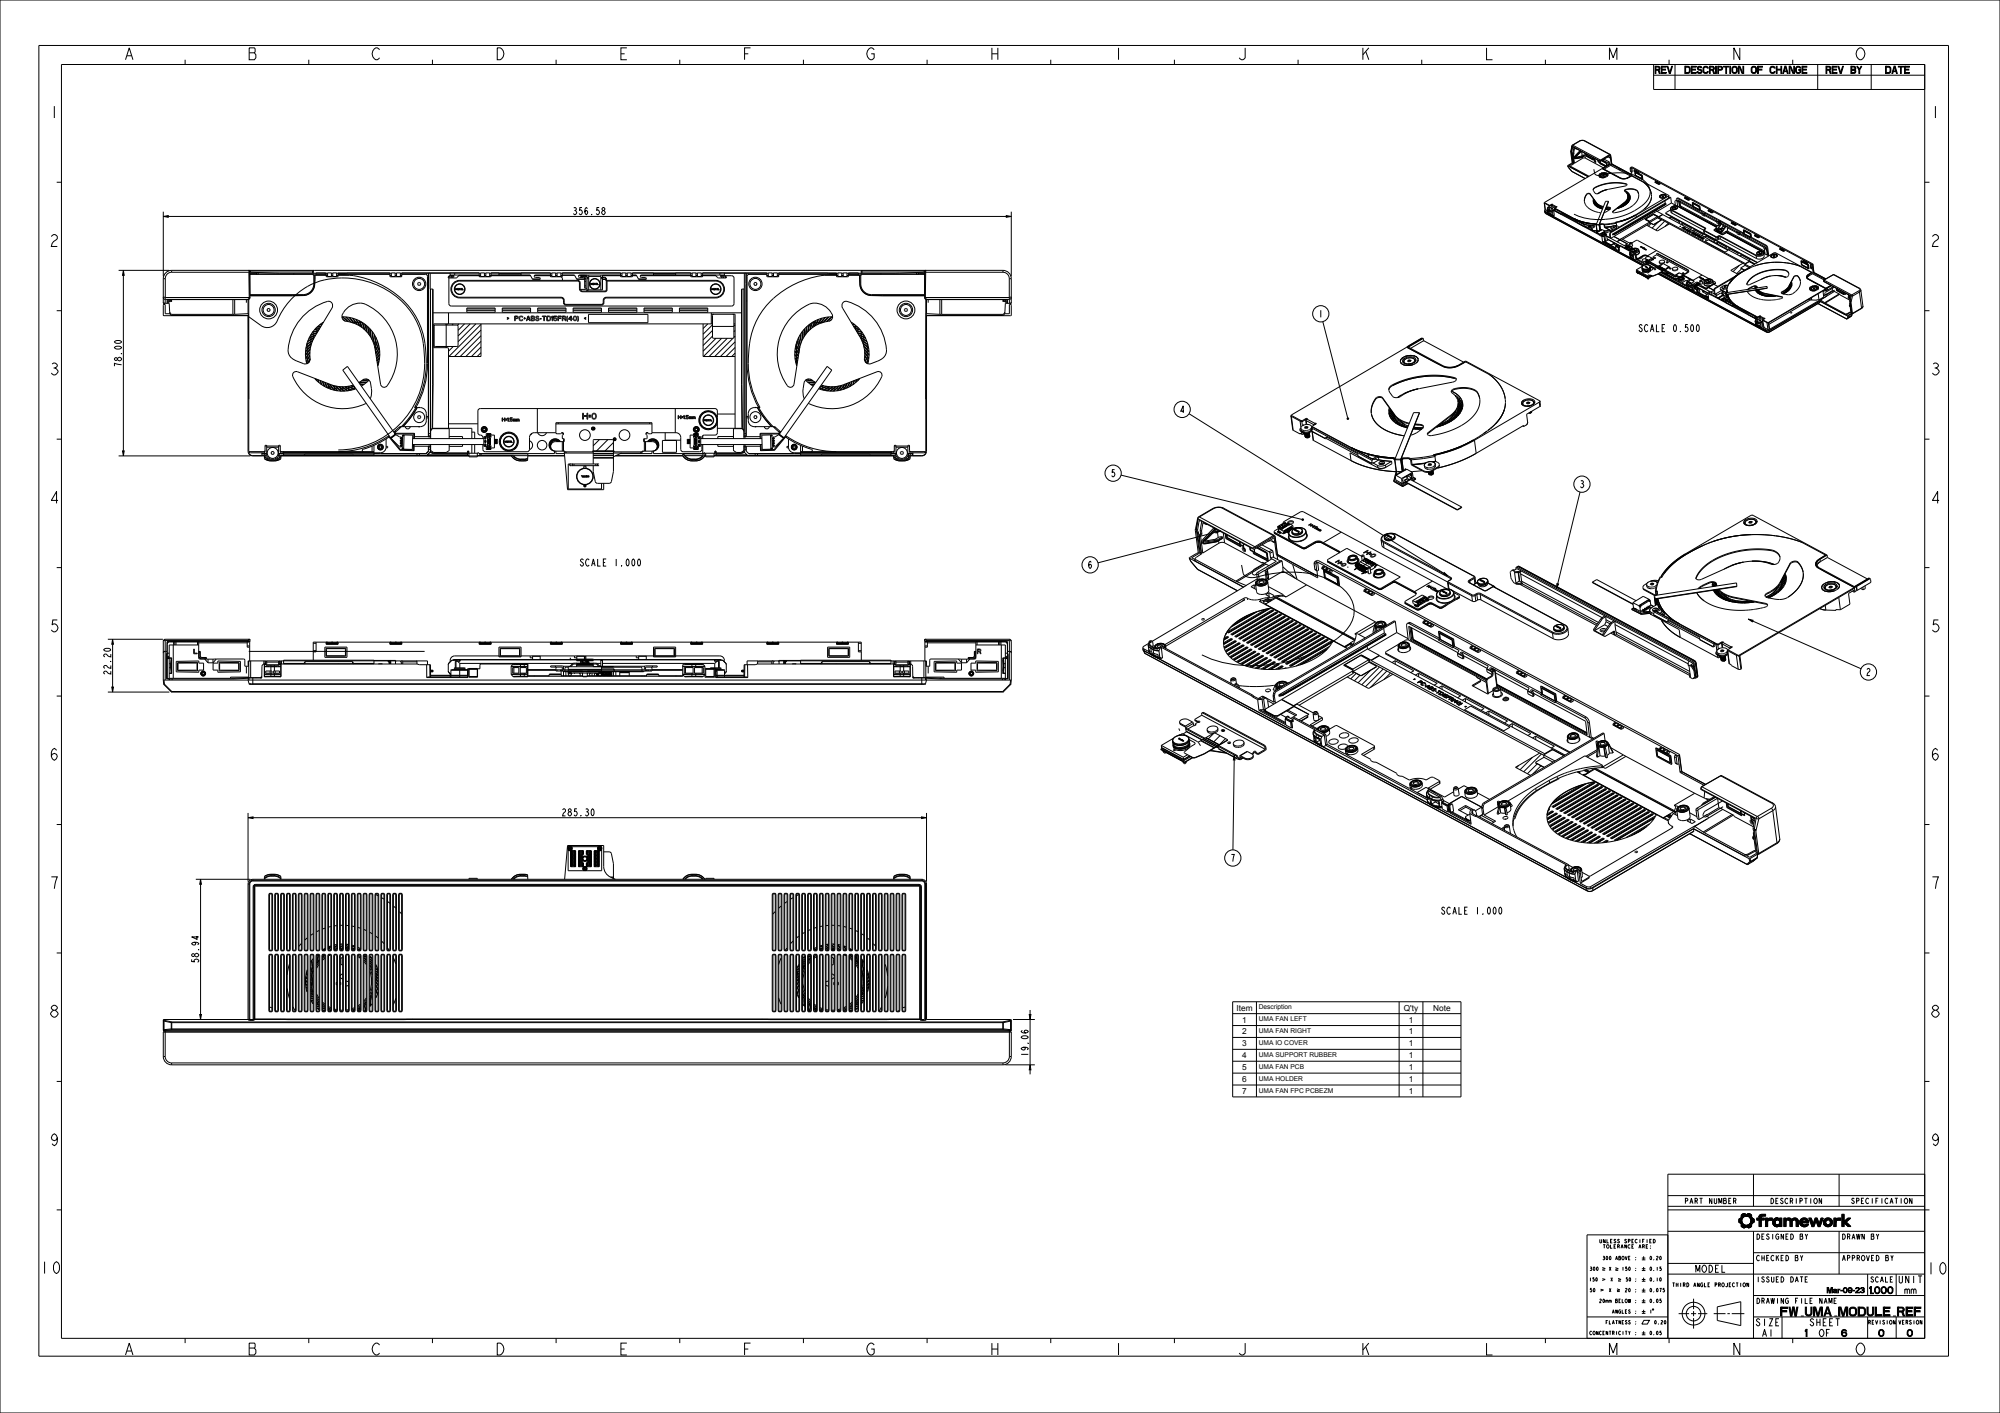
[picture p17: page 1]
PART NUMBER; DESCRIPTION; SPECIFICATION; MODEL; Mar-09-23 1.000; FW_UMA_MODULE_REF; SIZE; SHEET; REVISION VERSION; REV; DESCRIPTION OF CHANGEREV BY; DATE; UNLESS SPECIFIED TOLERANCE ARE:; 300 ABOVE :; 20mm BELOW :; ANGLES :; FLATNESS :; CONCENTRICITY : 0.05; SCALE 1.000; SCALE 0.500

Item | Description | Q'ty | Note
1 | UMA FAN LEFT | 1
2 | UMA FAN RIGHT | 1
3 | UMA IO COVER | 1
4 | UMA SUPPORT RUBBER | 1
5 | UMA FAN PCB | 1
6 | UMA HOLDER | 1
7 | UMA FAN FPC PCBEZM | 1

DESIGNED BY | DRAWN BY

CHECKED BY | APPROVED BY

ISSUED DATE | SCALEUNIT

THIRD ANGLE PROJECTION

DRAWING FILE NAME

2

2

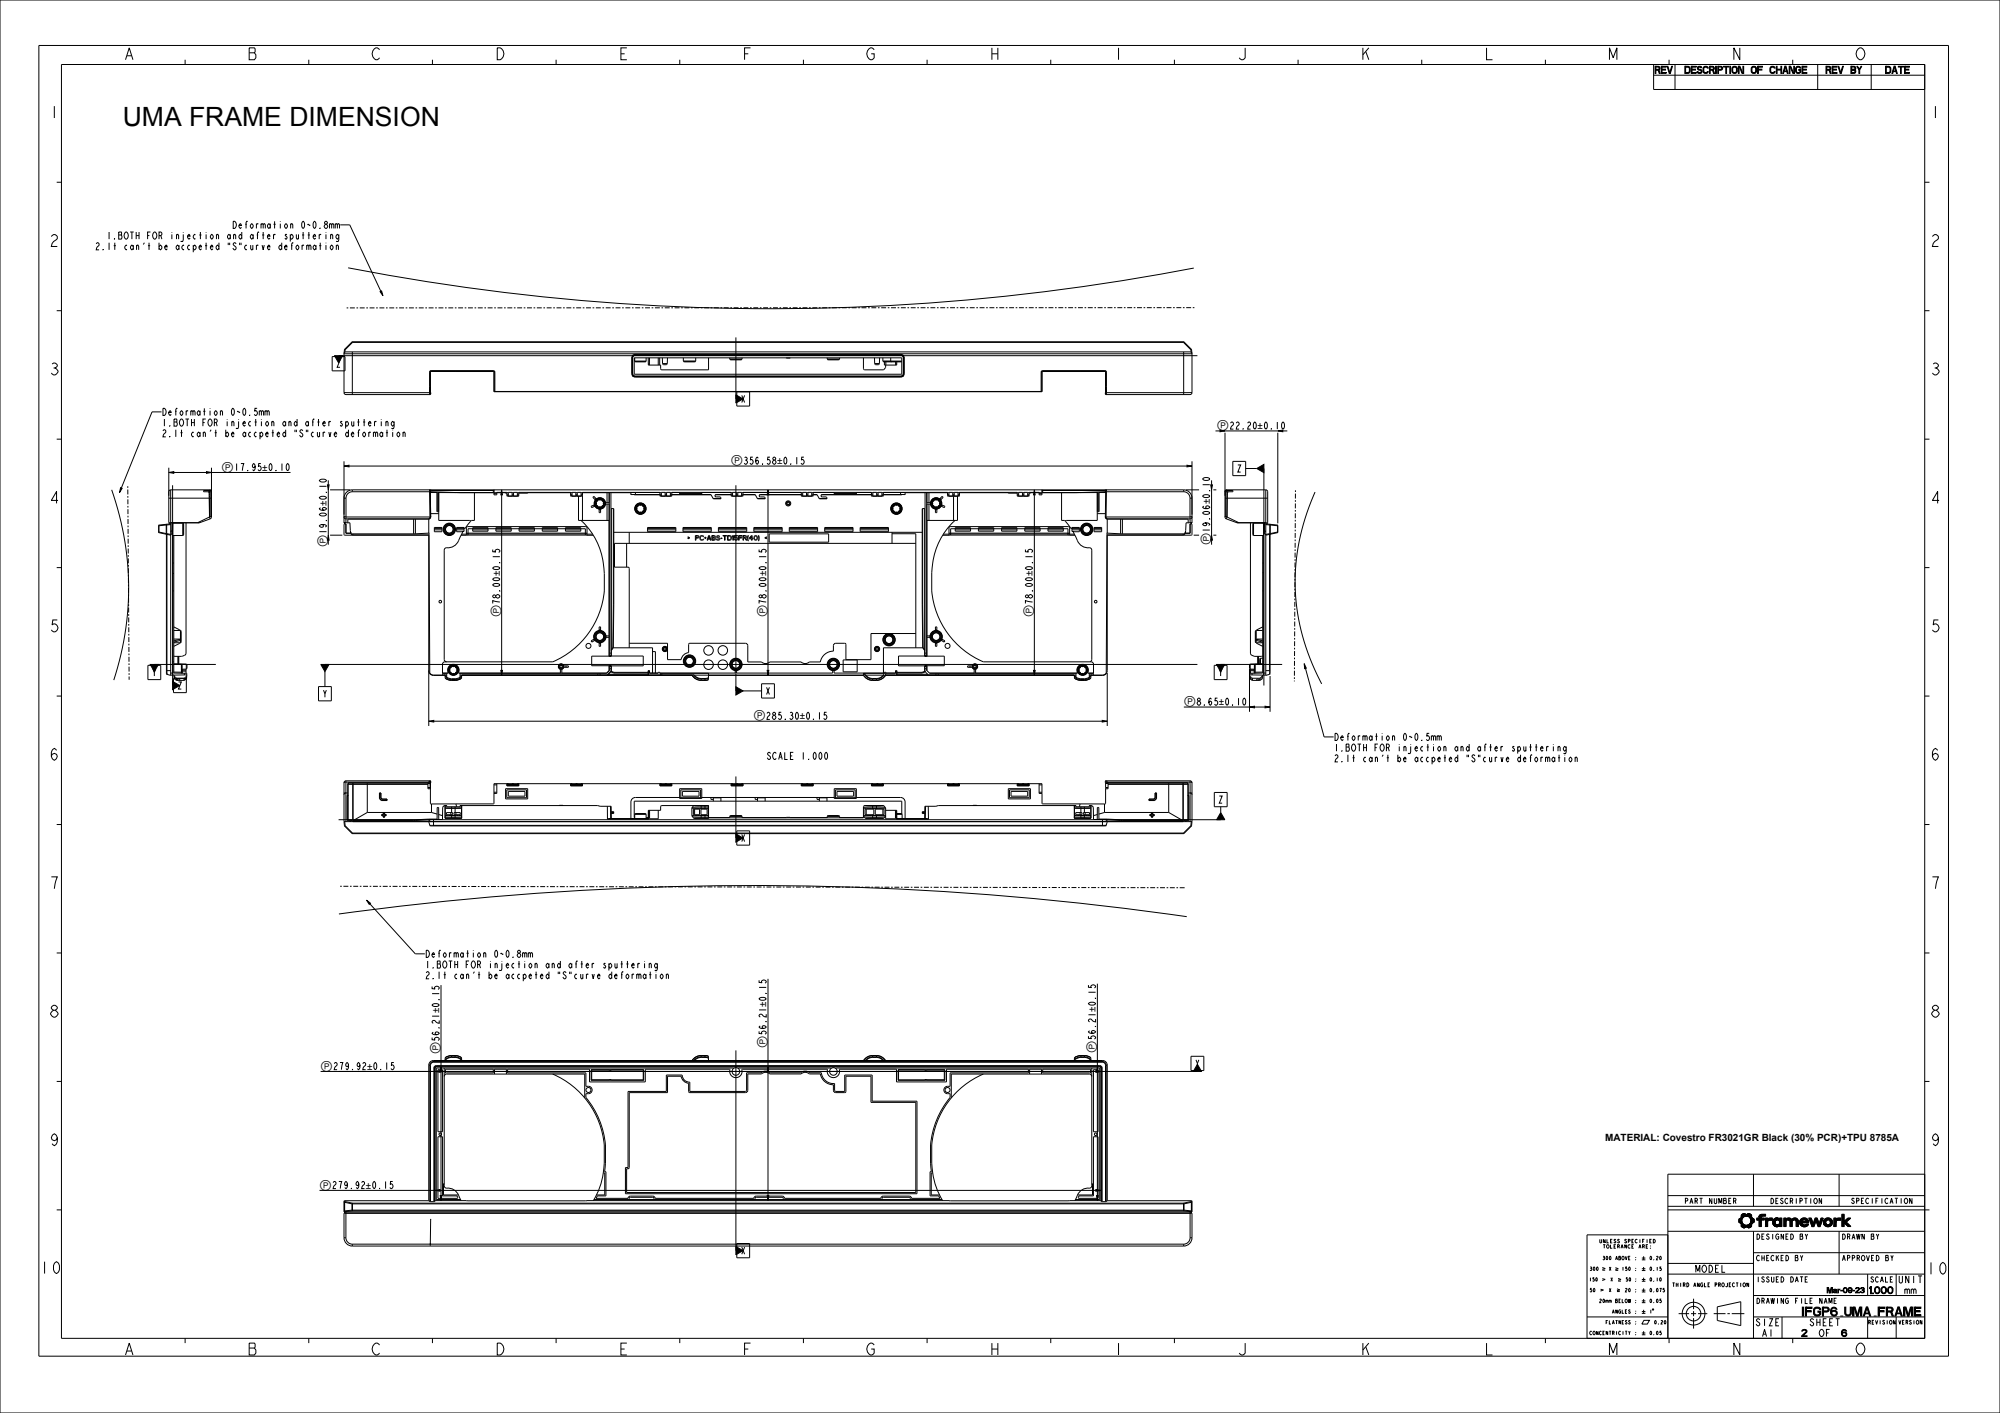
[picture p18: page 2]
PART NUMBER; DESCRIPTION; SPECIFICATION; MODEL; Mar-09-23 1.000; IFGP6_UMA_FRAME; UNLESS SPECIFIED TOLERANCE ARE:; 300 ABOVE :; Deformation 0~0.8mm; SCALE 1.000; 2.It can't be accpeted "S"curve deformation

UMA FRAME DIMENSION

1.BOTH FOR injection and after sputtering
2.It can't be accpeted "S"curve deformation

Deformation 0~0.5mm

Deformation 0~0.8mm

MATERIAL: Covestro FR3021GR Black (30% PCR)+TPU 8785A

DESIGNED BY | DRAWN BY

CHECKED BY | APPROVED BY

ISSUED DATE | SCALEUNIT

THIRD ANGLE PROJECTION

2

2

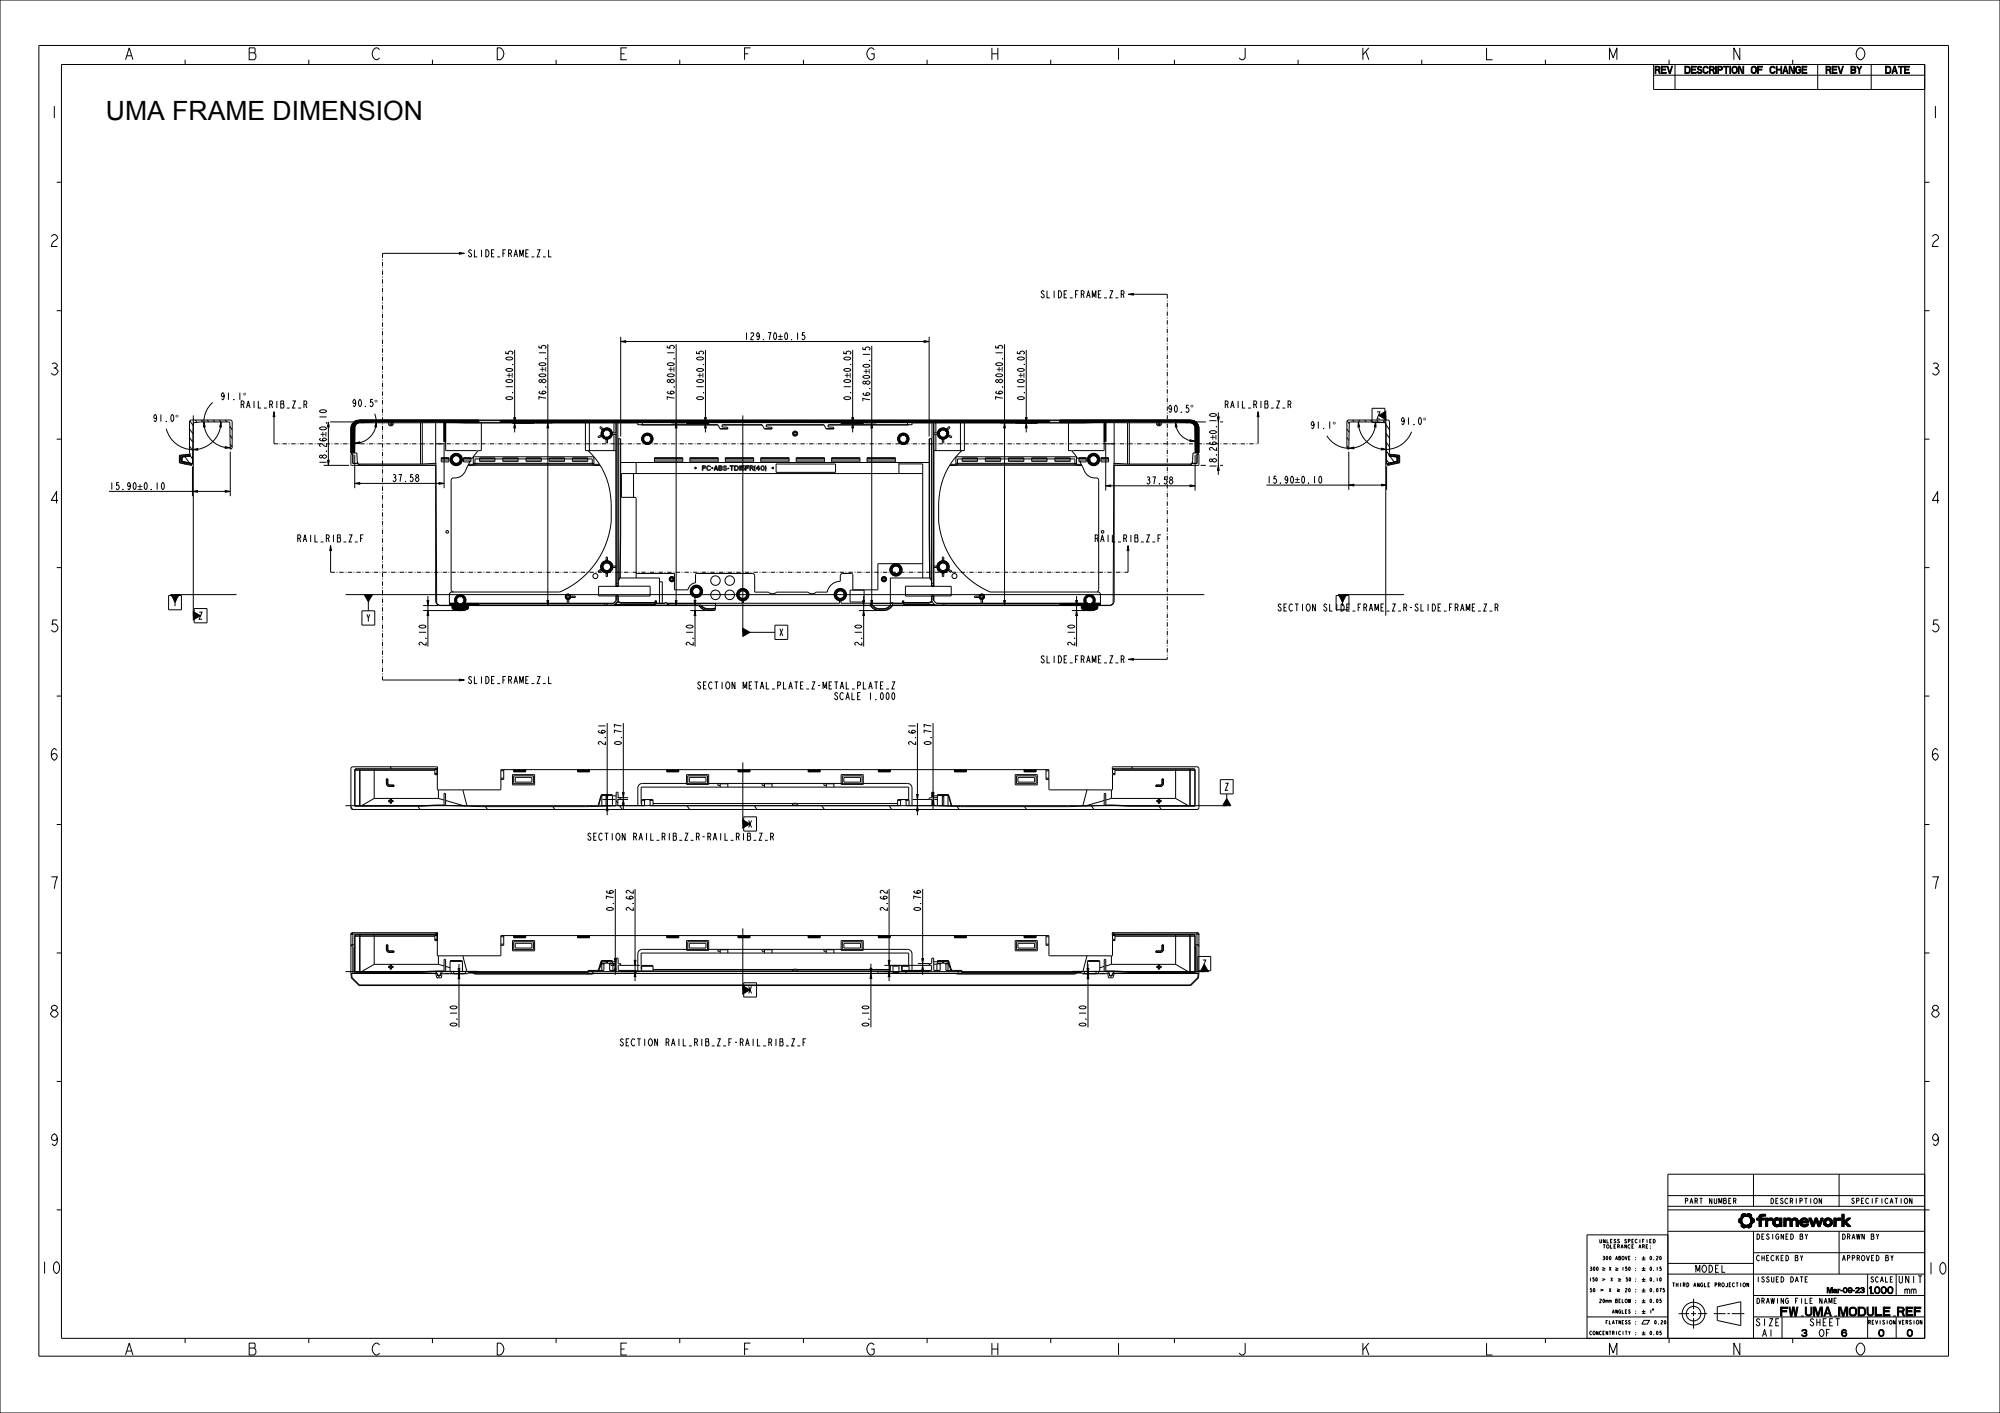
[picture p19: page 3]
PART NUMBER; DESCRIPTION; SPECIFICATION; MODEL; Mar-09-23 1.000; UNLESS SPECIFIED TOLERANCE ARE:; 300 ABOVE :; SECTION; METAL_PLATE_Z-METAL_PLATE_Z; SCALE 1.000; RAIL_RIB_Z_R-RAIL_RIB_Z_R; RAIL_RIB_Z_F-RAIL_RIB_Z_F; SLIDE_FRAME_Z_R-SLIDE_FRAME_Z_R

UMA FRAME DIMENSION

DESIGNED BY | DRAWN BY

CHECKED BY | APPROVED BY

ISSUED DATE | SCALEUNIT

THIRD ANGLE PROJECTION

2

2

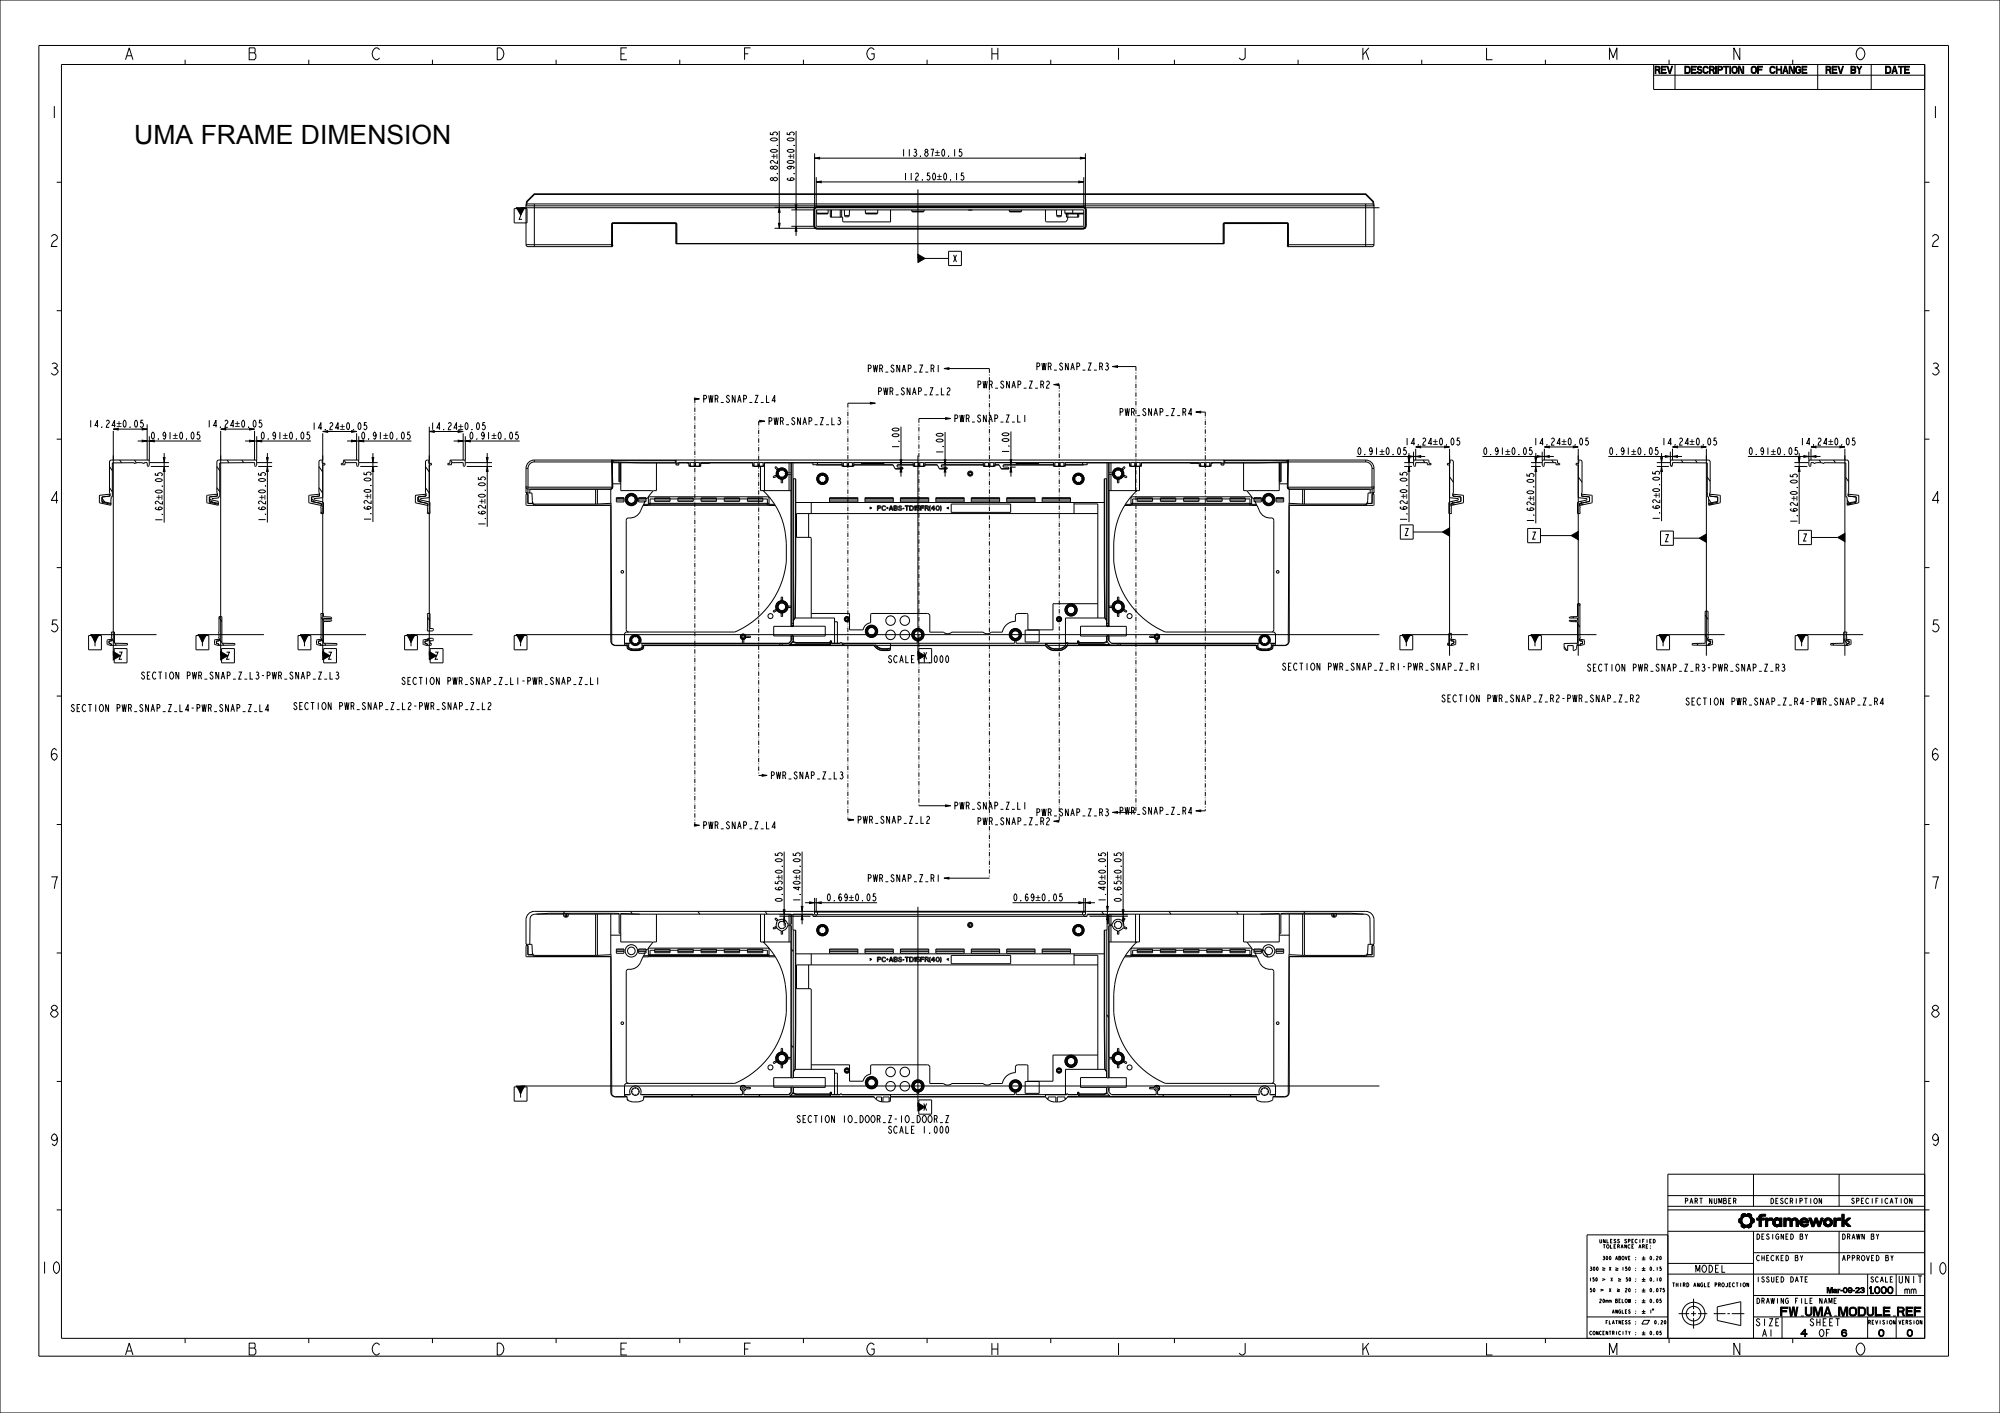
[picture p20: page 4]
PART NUMBER; DESCRIPTION; SPECIFICATION; MODEL; Mar-09-23 1.000; UNLESS SPECIFIED TOLERANCE ARE:; 300 ABOVE :; SCALE 1.000; SECTION; PWR_SNAP_Z_L1-PWR_SNAP_Z_L1; PWR_SNAP_Z_L2-PWR_SNAP_Z_L2; PWR_SNAP_Z_L3-PWR_SNAP_Z_L3; PWR_SNAP_Z_L4-PWR_SNAP_Z_L4; PWR_SNAP_Z_R1-PWR_SNAP_Z_R1; PWR_SNAP_Z_R2-PWR_SNAP_Z_R2; PWR_SNAP_Z_R3-PWR_SNAP_Z_R3; PWR_SNAP_Z_R4-PWR_SNAP_Z_R4; IO_DOOR_Z-IO_DOOR_Z

UMA FRAME DIMENSION

DESIGNED BY | DRAWN BY

CHECKED BY | APPROVED BY

ISSUED DATE | SCALEUNIT

THIRD ANGLE PROJECTION

2

2

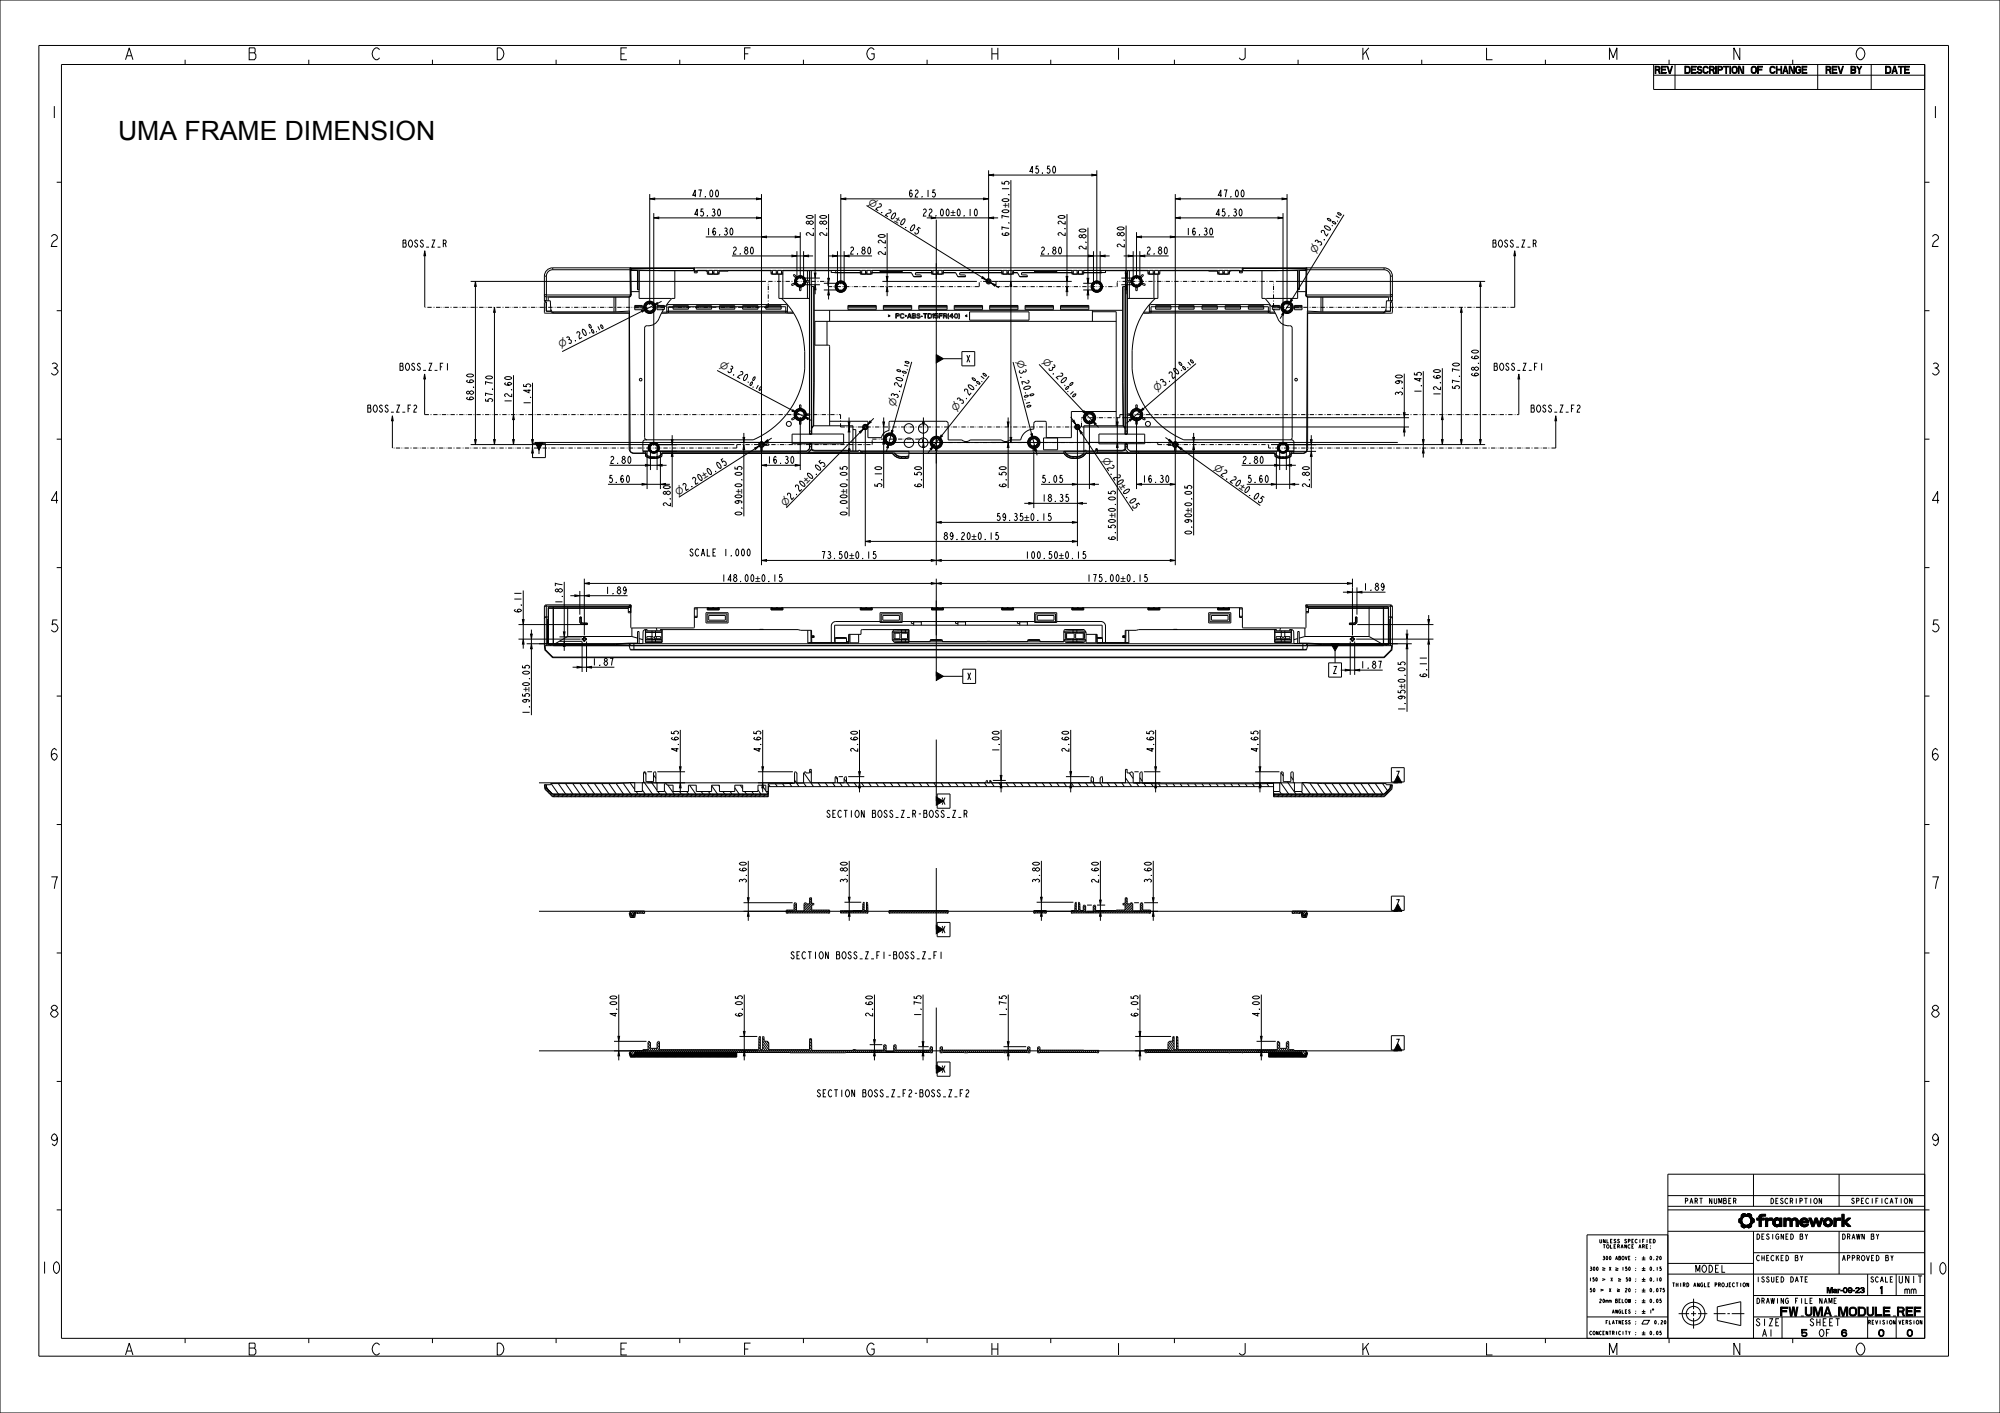
[picture p21: page 5]
PART NUMBER; DESCRIPTION; SPECIFICATION; MODEL; Mar-09-23; UNLESS SPECIFIED TOLERANCE ARE:; 300 ABOVE :; SCALE 1.000; SECTION; BOSS_Z_R-BOSS_Z_R; BOSS_Z_F1-BOSS_Z_F1; BOSS_Z_F2-BOSS_Z_F2

UMA FRAME DIMENSION

DESIGNED BY | DRAWN BY

CHECKED BY | APPROVED BY

ISSUED DATE | SCALEUNIT

THIRD ANGLE PROJECTION

2

2

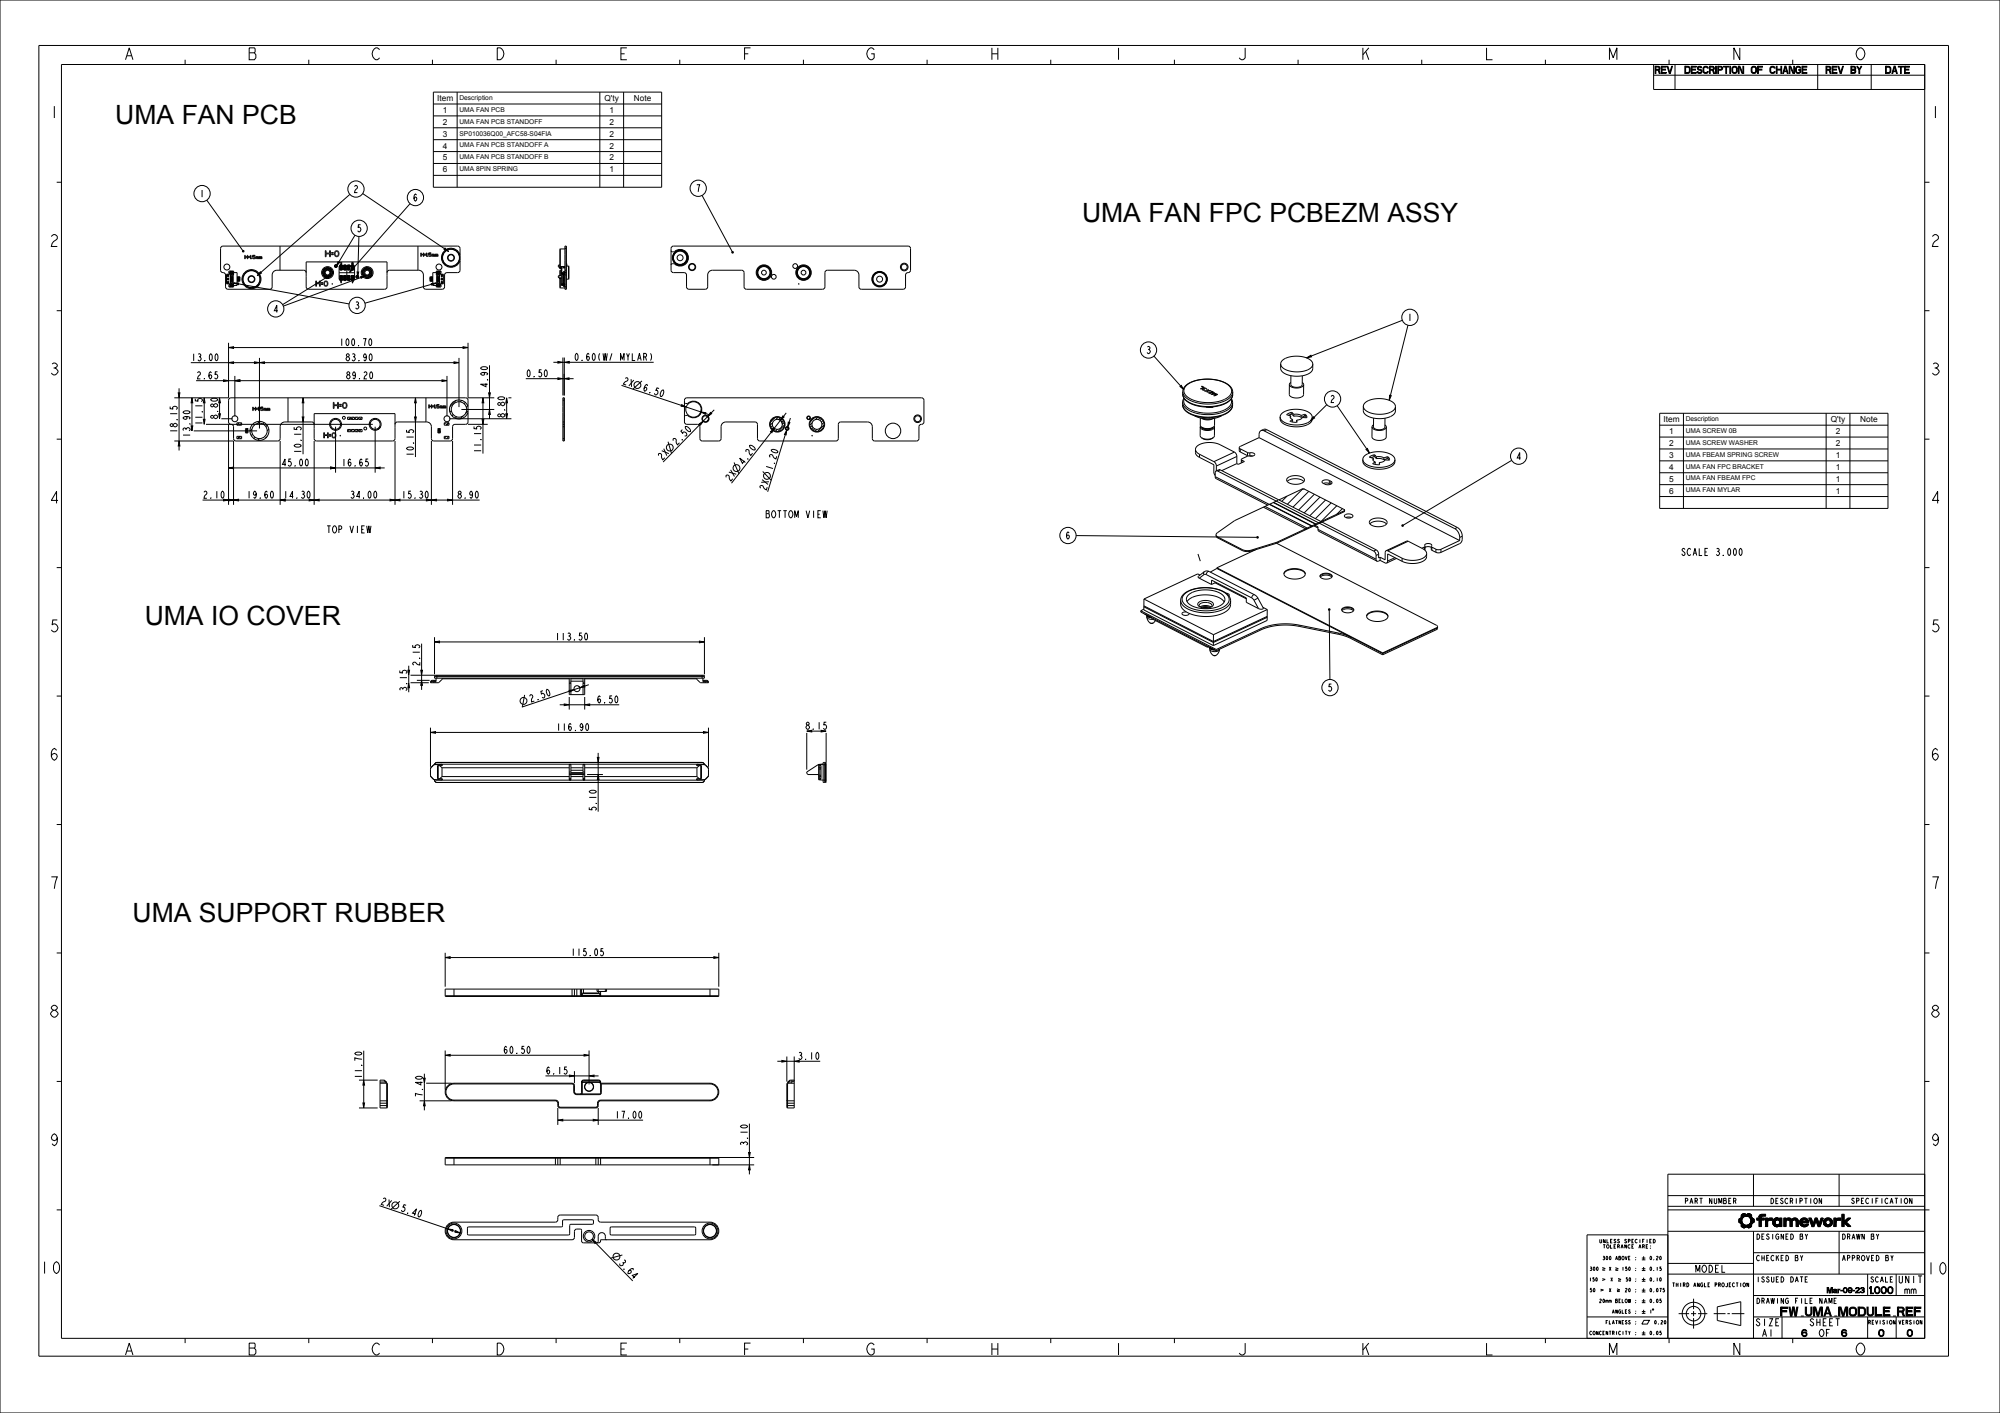
[picture p22: page 6]
0.60 (W/ MYLAR); PART NUMBER; DESCRIPTION; SPECIFICATION; MODEL; Mar-09-23 1.000; UNLESS SPECIFIED TOLERANCE ARE:; 300 ABOVE :; TOP VIEW; BOTTOM VIEW; SCALE 3.000

UMA FAN PCB

Item | Description | Q'ty | Note
1 | UMA FAN PCB | 1
2 | UMA FAN PCB STANDOFF | 2
3 | SP010036Q00_AFC58-S04FIA | 2
4 | UMA FAN PCB STANDOFF A | 2
5 | UMA FAN PCB STANDOFF B | 2
6 | UMA 8PIN SPRING | 1

UMA FAN FPC PCBEZM ASSY

1 | UMA SCREW 0B | 2
2 | UMA SCREW WASHER | 2
3 | UMA FBEAM SPRING SCREW | 1
4 | UMA FAN FPC BRACKET | 1
5 | UMA FAN FBEAM FPC | 1
6 | UMA FAN MYLAR | 1

UMA IO COVER

UMA SUPPORT RUBBER

DESIGNED BY | DRAWN BY

CHECKED BY | APPROVED BY

ISSUED DATE | SCALEUNIT

THIRD ANGLE PROJECTION
