FrameworkComputer/ExpansionBay/Electrical/Dual-channel 74P FXBeam, length 27.75mm _Rev 2_(Public version).pdf

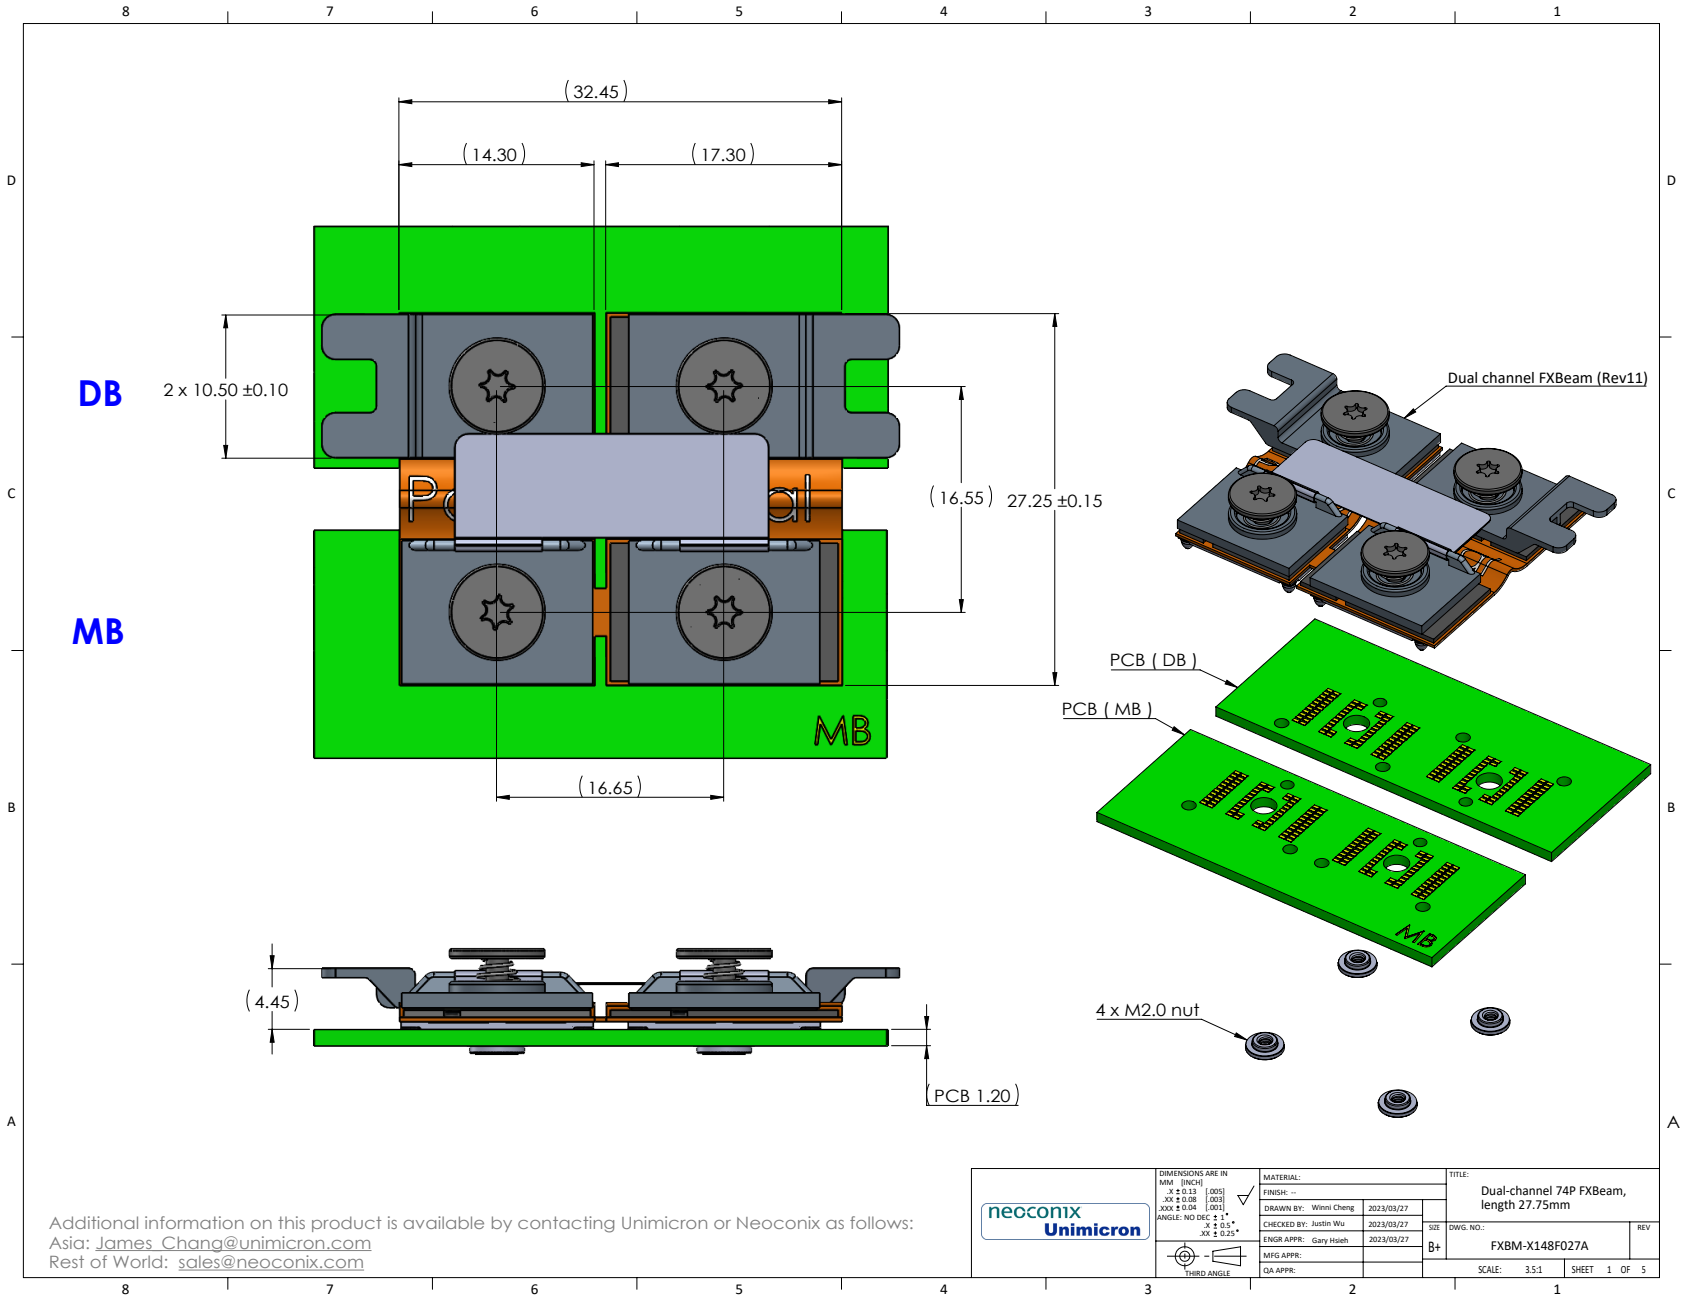
[picture p23: page 1]
PCB 1.20; PCB ( DB ); PCB ( MB ); 4 x M2.0 nut; THIRD ANGLE; QA APPR:; MFG APPR:; DRAWN BY: CHECKED BY: ENGR APPR:; FINISH: --; SCALE:; SHEET 1 OF 5; Justin Wu; Gary Hsieh; Winni Cheng; DWG. NO.:; Dual-channel 74P FXBeam, length 27.75mm

Dual channel FXBeam (Rev11)

DIMENSIONS ARE IN
MM [INCH]

.XXX
ANGLE: NO DEC

Additional information on this product is available by contacting Unimicron or Neoconix as follows:
Asia: James_Chang@unimicron.com
Rest of World: sales@neoconix.com

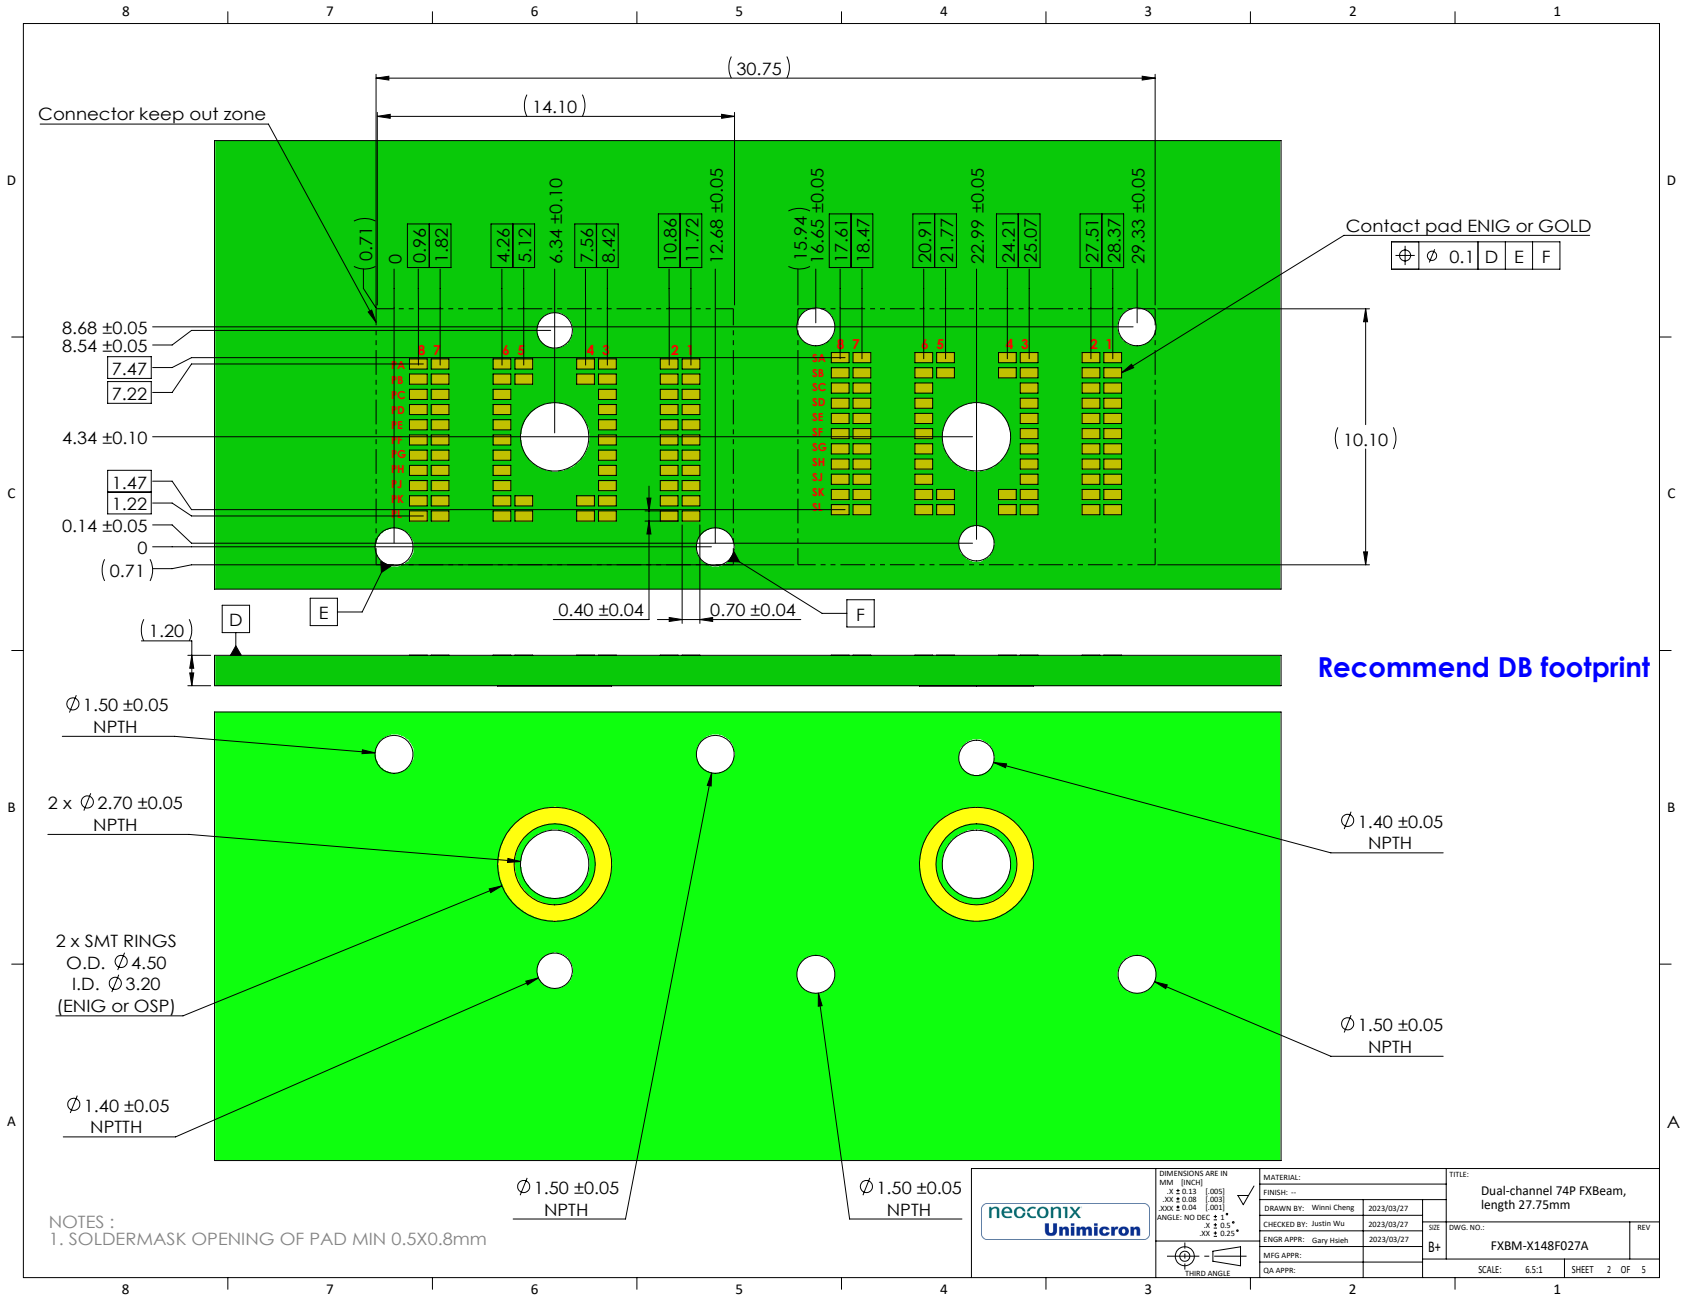
[picture p24: page 2]
2 x SMT RINGS O.D. 4.50 I.D. 3.20 (ENIG or OSP); SCALE:; SHEET 2 OF 5

Connector keep out zone

Contact pad ENIG or GOLD

Recommend DB footprint

DIMENSIONS ARE IN
MM [INCH]

TITLE:
Dual-channel 74P FXBeam,

NOTES :
1. SOLDERMASK OPENING OF PAD MIN 0.5X0.8mm

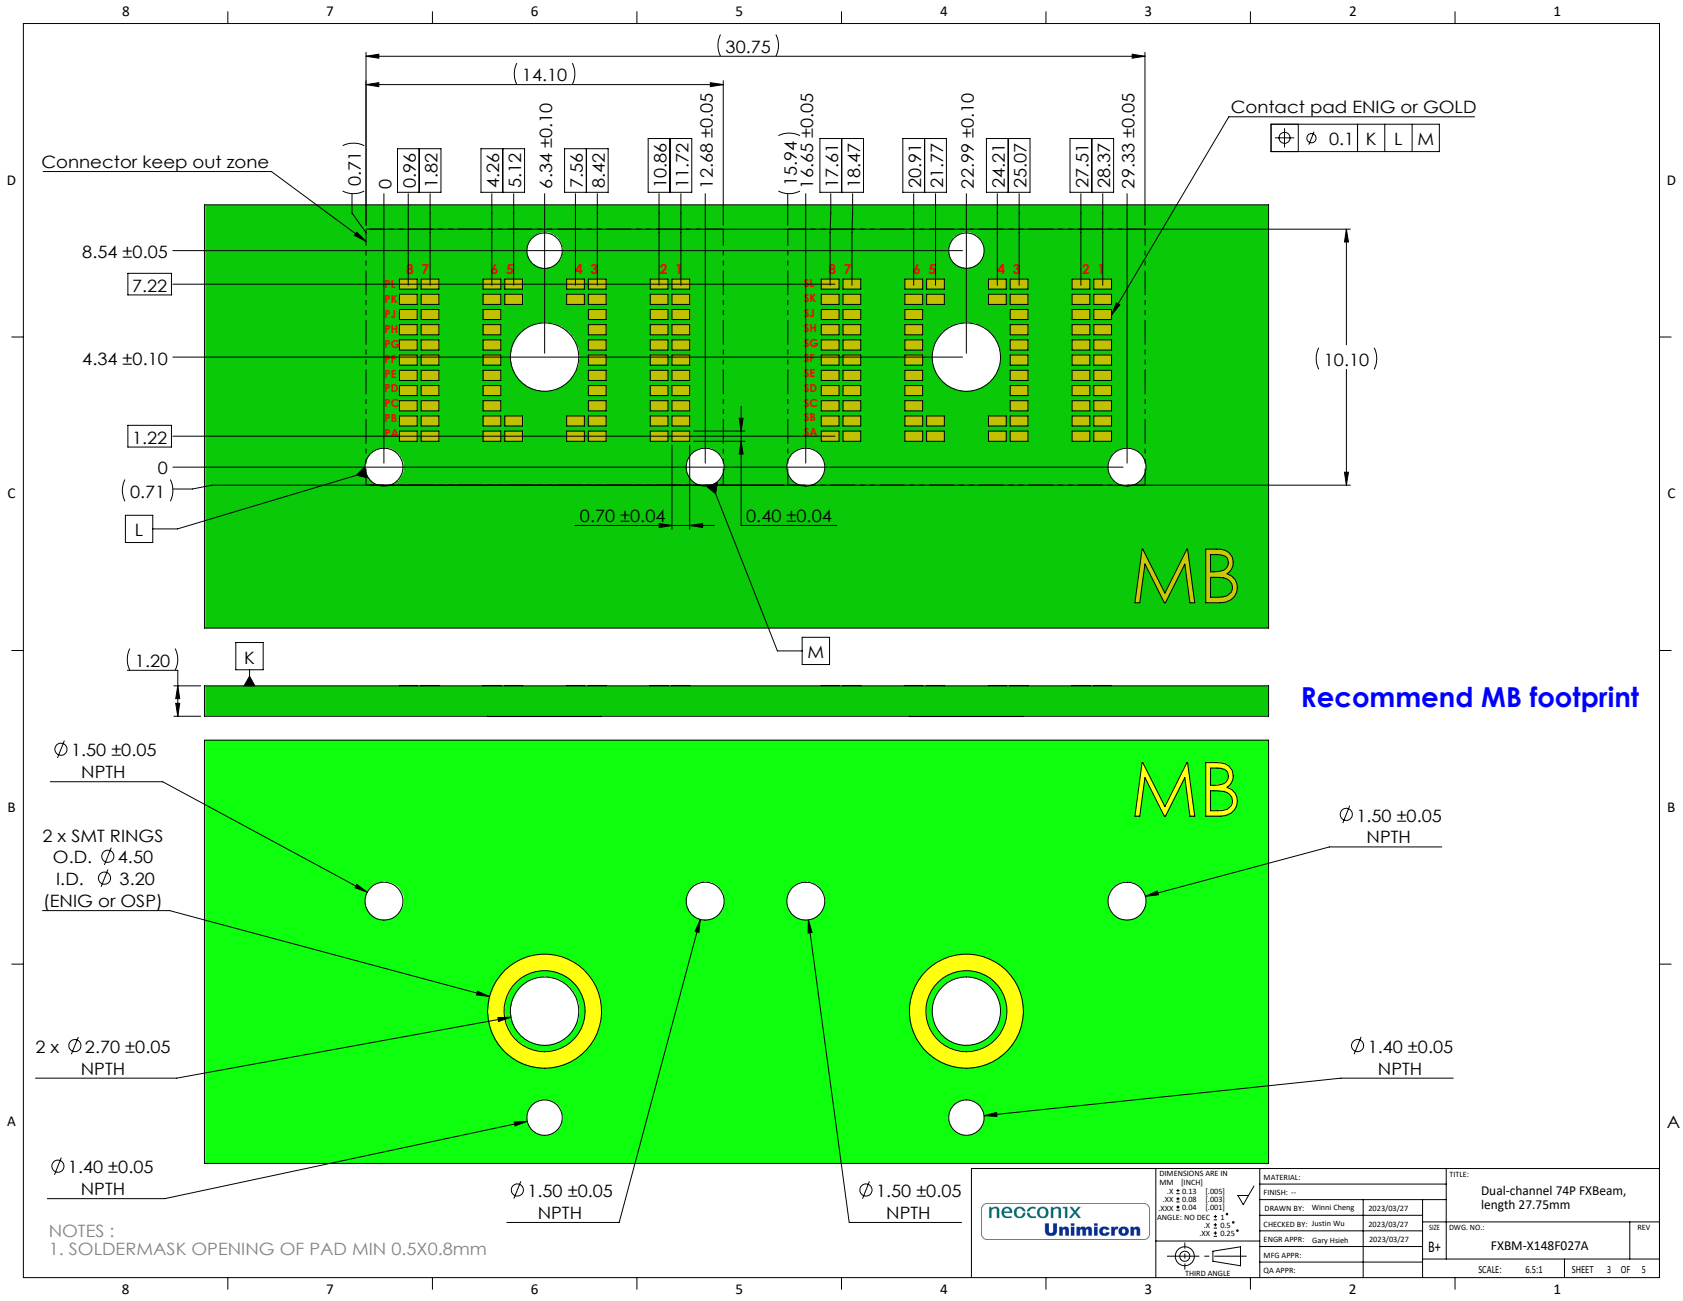
[picture p25: page 3]
SCALE:; SHEET 3 OF 5

Contact pad ENIG or GOLD

Connector keep out zone

Recommend MB footprint

2 x SMT RINGS
(ENIG or OSP)

NPTH
NOTES :
1. SOLDERMASK OPENING OF PAD MIN 0.5X0.8mm

DIMENSIONS ARE IN
MM [INCH]

TITLE:
Dual-channel 74P FXBeam,

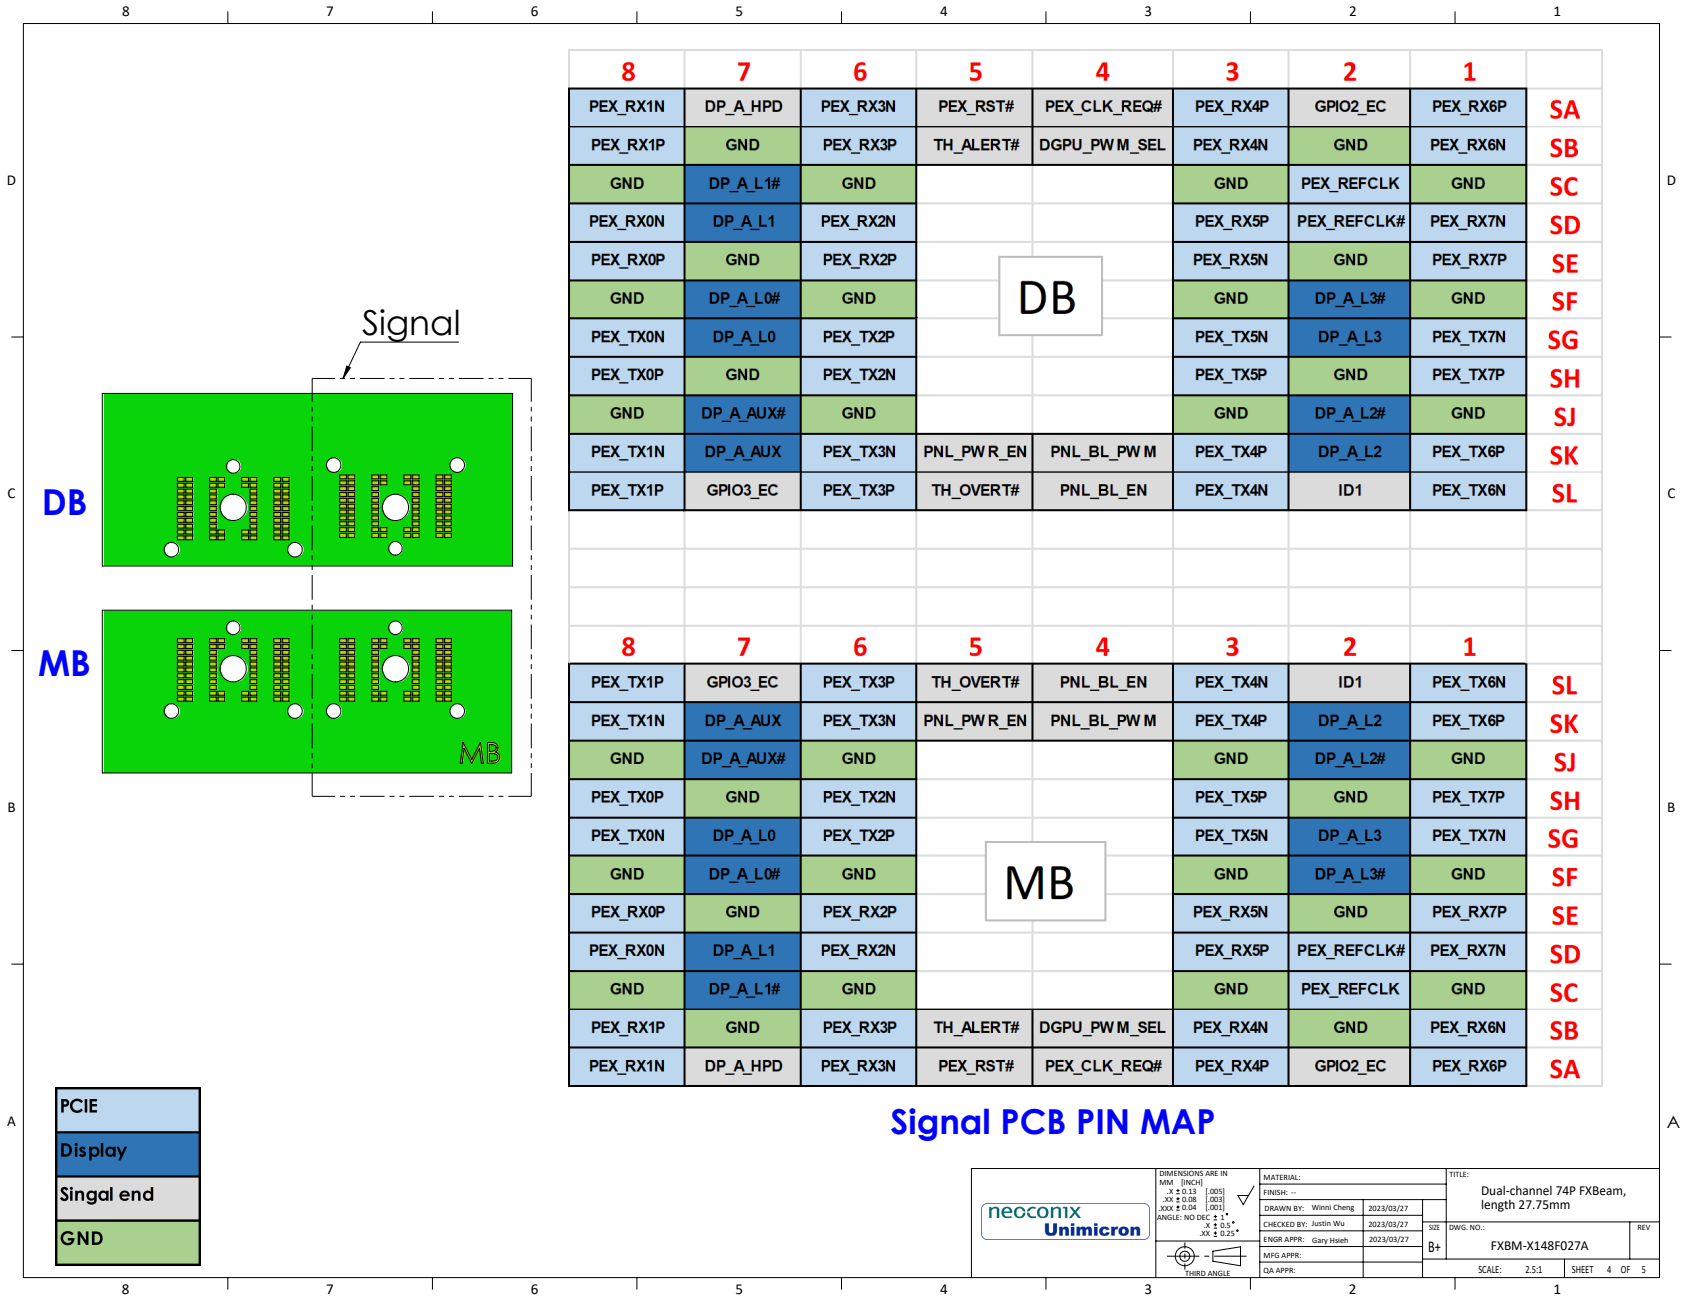
[picture p26: page 4]
SCALE:; SHEET 4 OF 5

Signal PCB PIN MAP

DIMENSIONS ARE IN
MM [INCH]

TITLE:
Dual-channel 74P FXBeam,

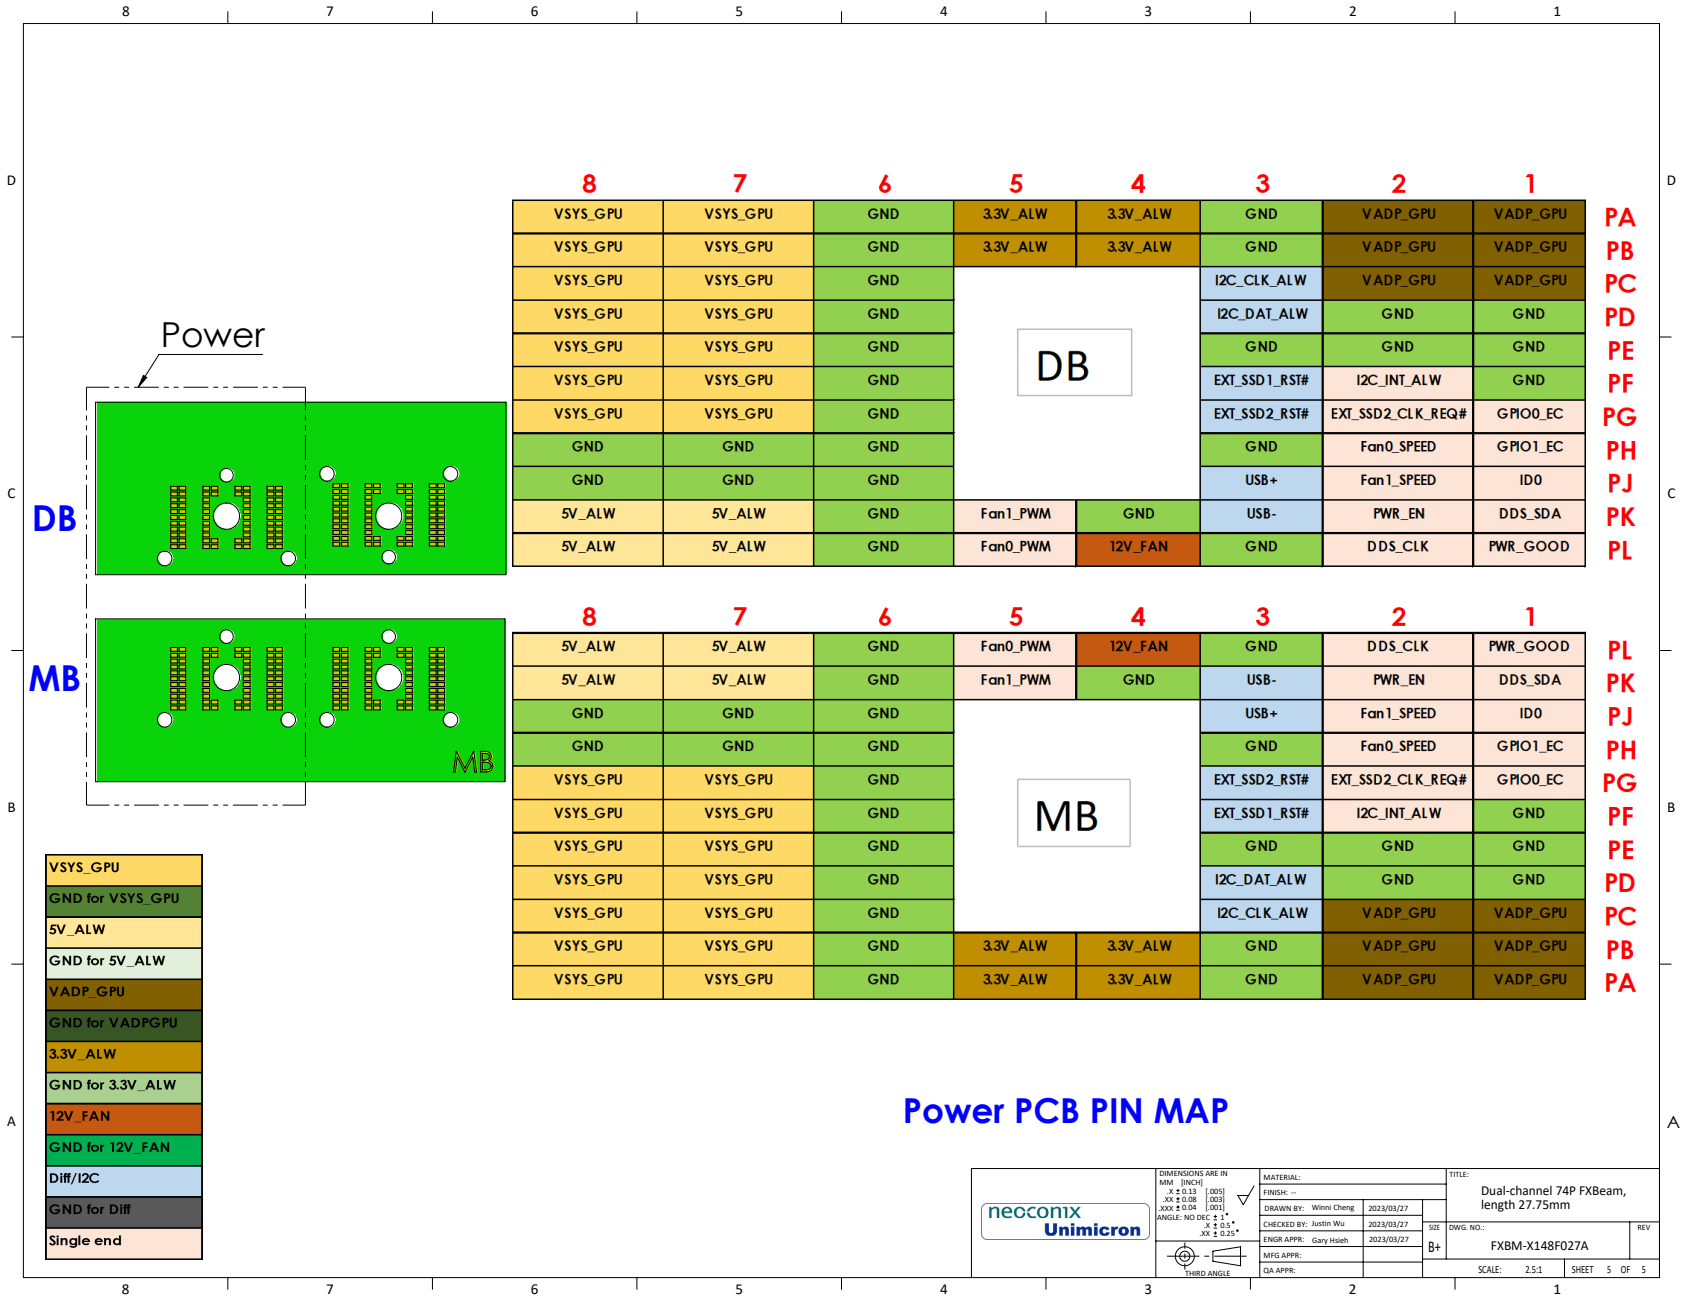
[picture p27: page 5]
SCALE:; SHEET 5 OF 5

Power PCB PIN MAP

DIMENSIONS ARE IN
MM [INCH]

TITLE:
Dual-channel 74P FXBeam,
