FrameworkComputer/ExpansionBay/(commit log)

2023-03-20 Upload dual SSD reference design drawings
    [fw_ssd_pcb_ref_design_0_1.dxf, fw_ssd_pcb_ref_design_0_2.dxf]
2023-03-20 Move SSD folder and add schematic
    [fw_ssd_pcb_ref_design_0_1.dxf, fw_ssd_pcb_ref_design_0_2.dxf]
2023-03-21 PCB reference design drawings
    [FW_EXPANSION_BAY_PCB_0.stp, fw_expansion_bay_pcb_0-1.dxf, fw_expansion_bay_pcb_0-2.dxf]
2023-08-07 Update PCB reference CAD
    [FW_EXPANSION_BAY_PCB_0.stp, FW_EXPANSION_BAY_PCB_0807.stp, fw_expansion_bay_pcb_0-1.dxf, fw_expansion_bay_pcb_0-2.dxf, fw_expansion_bay_pcb_01_0807.dxf, fw_expansion_bay_pcb_02_0807.dxf]
2023-08-29 SMT nut drawing
2024-03-08 Add fan connector
2024-09-01 Add links to footprint and symbol
2024-12-31 Add Graphics Module CAD
